Xinyuan-LilyGO/T-Echo-Lite/tools/win10 vscode platformio start/README.md

### Installing t-echo-lite board type for VSCode PlatformIO on Windows 10

* * *
1. Install [Python](https://www.python.org/downloads/).
    
2. Install
    
    Open cmd in the current directory and run the following program:
    
        python t-echo-lite_setup.py
