Xinyuan-LilyGO/T-Echo-Lite/firmware/[nRF52840_Module_V1.0][nrf52840_module]_firmware/README.md

# Firmware Modification Log

## 202607140916
### Changed firmware
- `[nRF52840_Module_V1.0][nrf52840_module]_firmware_202607140916`
### Change content
- 更新flash新型号兼容ZD25Q32D
