Xinyuan-LilyGO/T-Echo-Lite/image/10.png

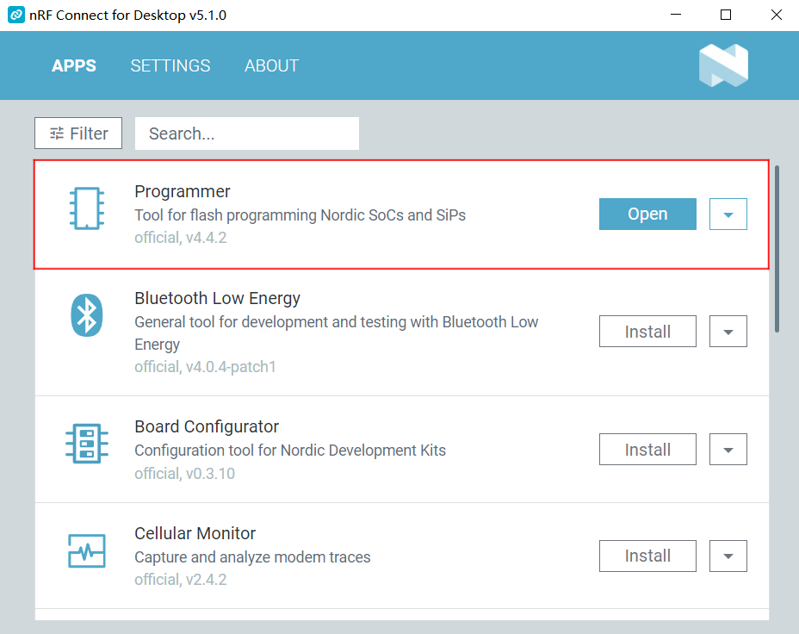
image/10.png
