Xinyuan-LilyGO/T-Echo-Lite/image/11.png

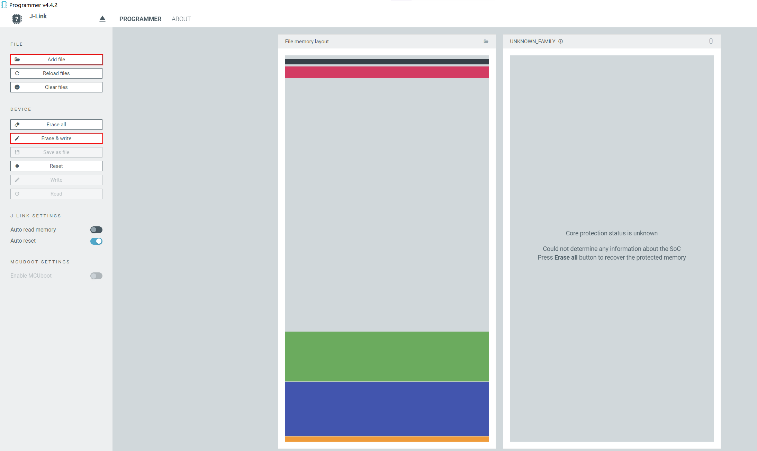
image/11.png
