Xinyuan-LilyGO/T-Echo-Lite/project/T-Echo-Lite_V1.0/3D_T-Echo-Lite-Eapper_Bot_202506101005.png

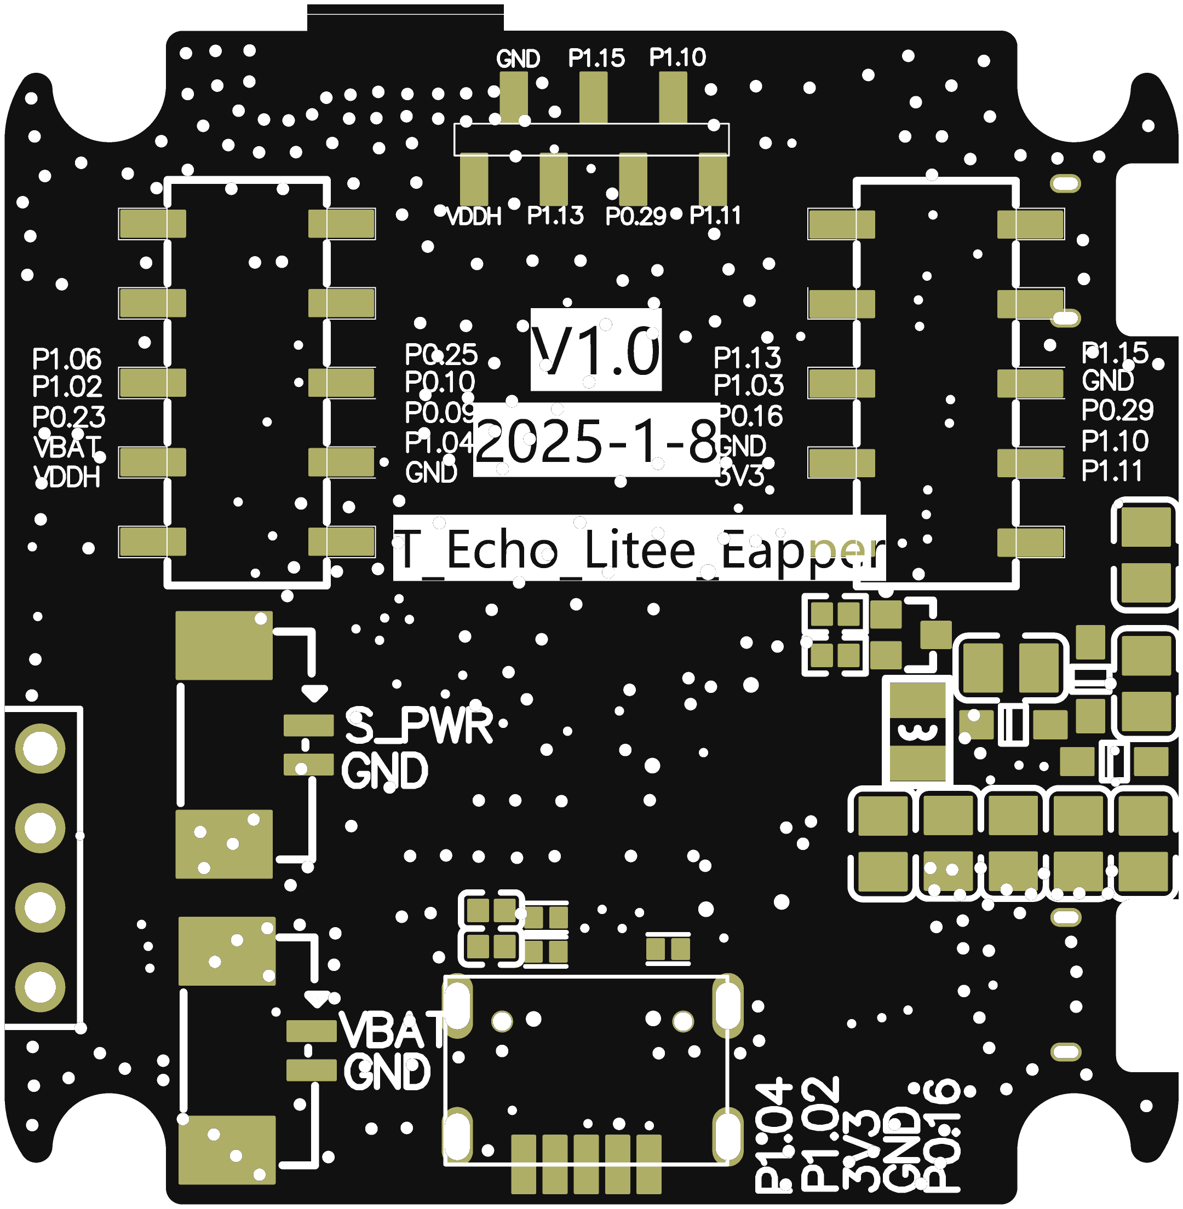
project/T-Echo-Lite_V1.0/3D_T-Echo-Lite-Eapper_Bot_202506101005.png
