Xinyuan-LilyGO/T-Echo-Lite/structure/总装.stl

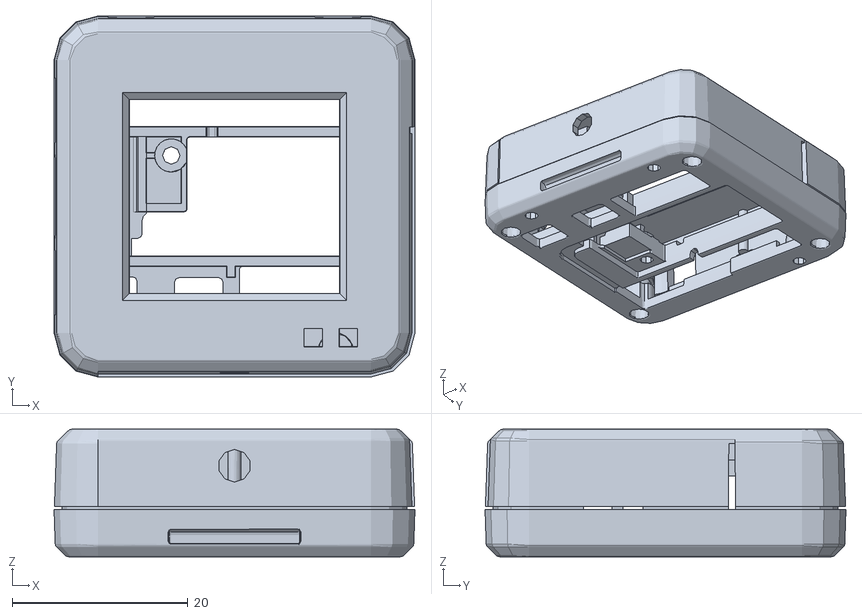
[picture p13: CAD file, 2025-06-09]
structure/总装.stl
41.0 x 41.0 x 14.5
