Xinyuan-LilyGO/T-Echo-Lite/structure/下壳.stl

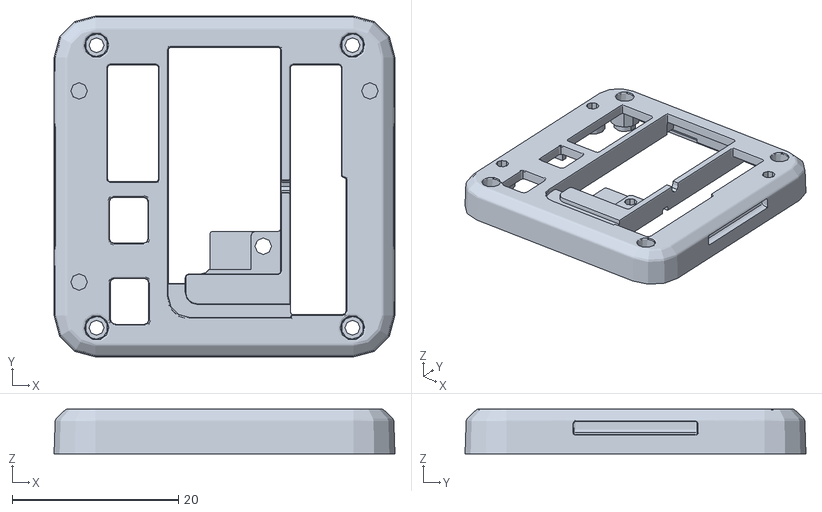
[picture p14: CAD file, 2025-06-09]
structure/下壳.stl
41.0 x 41.0 x 5.40
