Xinyuan-LilyGO/T-Echo-Lite/structure/上壳.stl

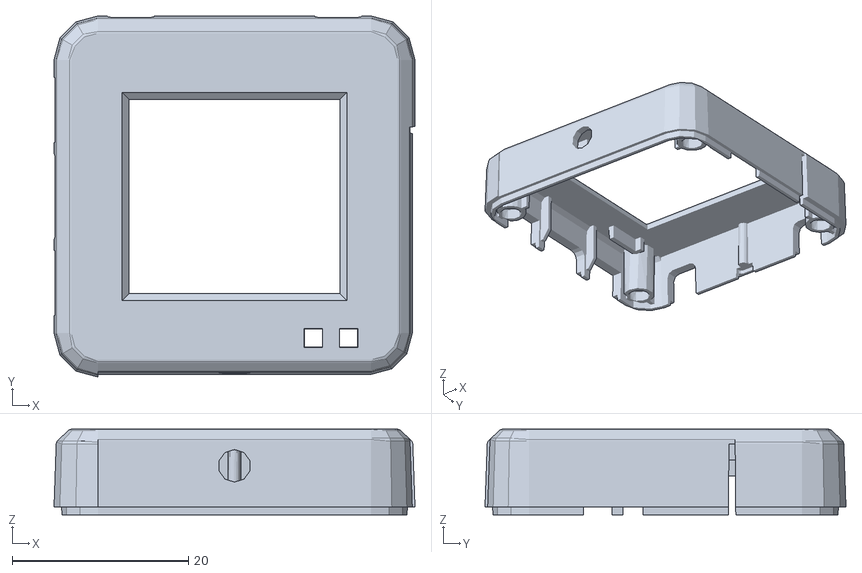
[picture p15: CAD file, 2025-06-09]
structure/上壳.stl
40.9 x 40.9 x 9.70
