Xinyuan-LilyGO/T-Echo-Lite/firmware/[T-Echo-Lite_V1.0][Original_Test]_firmware/README.md

# Firmware Modification Log

## 202607140937
### Changed firmware
- `[T-Echo-Lite_V1.0][Original_Test]_firmware_202607140937`
### Change content
- 将sx1262测试提到第一个测试，更新flash新型号兼容ZD25Q32D
