Xinyuan-LilyGO/T-Echo-Lite/firmware/[T-Echo-Lite-KeyShield_V1.0][original_test]_firmware/修改日志.md

## 202604090958
> #### [T-Echo-Lite-KeyShield_V1.0][original_test]_firmware_202604090958: 
>  * 添加自动进入浅睡眠

## 202512091700
> #### [T-Echo-Lite-KeyShield_V1.0][original_test]_firmware_202512091700: 
>  * 修复扬声器播放杂音问题

## 202511141051
> #### [T-Echo-Lite-KeyShield_V1.0][original_test]_firmware_202511141051: 
>  * 添加屏幕局部刷新功能，修复屏幕刷新卡顿问题

## 202510301608
> #### [T-Echo-Lite-KeyShield_V1.0][original_test]_firmware_202510301608: 
>  * 初始版本
