Xinyuan-LilyGO/T-Echo-Lite/(threads)

Thread 1 (2025-05-04):

Footprint for Core

lumo76, 2025-05-04:
### What features or library support or other would you like to add?

I would like to see a footprint of the core module which can be imported into kicad.

### Additional context.

_No response_

eabase, 2025-05-21:
➕1️⃣
Yes, a schematic would be much appreciated!
Especially since there are several ports and buttons not yet documented.

Llgok, 2025-05-22:
@eabase
Hello, we don't have a KiCad footprint library here. You can use specific tools to convert the footprints from our project library [T_Echo_lite.PcbLib](https://github.com/Xinyuan-LilyGO/T-Echo-Lite/blob/main/project/T-Echo-Lite_V1.0/T_Echo_lite.PcbLib) into a KiCad-compatible version.

eabase, 2025-05-22:
@Llgok
> You can use specific tools to convert

What tools? Convert from what exactly?

lumo76, 2025-05-22:
@Llgok
thanks, the .PcbLib file helps. Could you provide the symbol file for the core module as well, e.g. the .SchLib file?

lumo76, 2025-05-22:
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

kicad can import the footprint lib directly. E.g. https://forum.kicad.info/t/importing-altium-pcblib-files/39050

Llgok, 2025-05-24:
@lumo76
Updated [T_Echo_lite.SchLib](https://github.com/Xinyuan-LilyGO/T-Echo-Lite/blob/main/project/T-Echo-Lite_V1.0/T_Echo_lite.SchLib)

eabase, 2025-06-01:
@Llgok
Can you please alsoi provide the **`*.SchDoc`** file?

Llgok, 2025-06-04:
@eabase I am very sorry, but I am unable to provide you with the .SchDoc file and KiCad-related files. If you need to convert package library files and schematic library files, you can refer to the following open-source projects:[pcad2kicad](https://github.com/xtoolbox/pcad2kicad)

eabase, 2025-06-04:
@Llgok
You're not reading my post. **`*.SchDoc`** **is an Altium produced file**, and is needed in order import the schematics from anything else.

eabase, 2025-06-08:
Hi @Llgok
Unfortunately none of the files are rendering correctly.
The schematics only show 3 parts, and rendered outside the drawing boarders.

Can you can see and check for yourself by using the latest KiCad `9.0.2`.

Ultimately I would like to have the files for all the components in the `T-Echo-Lite` (with case and display).

---

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

Llgok, 2025-06-09:
Hello,@eabase
The exported file is fine. It contains the schematic and encapsulation of the T-Echo-Lite-Core_V1.0 module. If you are looking for the source project files for T-Echo-Lite (including the routed schematic (.SchDoc file), routed PCB (.PcbDoc file), and manufacturable Gerber files), I apologize that we cannot provide these source files at the moment due to confidentiality agreements. I will upload the shell files shortly.

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

Thread 2 (2025-05-21):

Documentation missing

eabase, 2025-05-21:
Hi,

I am missing all the documentation of the various ports, connectors and buttons.
1. Can you please upload the schematics and clearly document the side ports and 2 buttons?

2. How I can connect a GPS?

Also, you are referring to the **L67**` GPS module which is nowhere to be found.

3. **How/where can I get one, and how to connect in the meantime?**

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

Llgok, 2025-05-22:
@eabase
Hello, thank you very much for your feedback.

1.  You can access the schematic diagram of this project [Echo-Lite_V1.0](https://github.com/Xinyuan-LilyGO/T-Echo-Lite/blob/main/project/T-Echo-Lite_V1.0/T-Echo-Lite_V1.0.pdf), or directly visit the pin configuration interface [pinoverview](https://github.com/Xinyuan-LilyGO/T-Echo-Lite?tab=readme-ov-file#pinoverview) to obtain the corresponding IO numbers for MUC connections with other hardware devices.

2.  The connection method for GPS is designed according to the shell structure. You can confirm the GPS connection by referring to the reserved position for the GPS module in this diagram.
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

3.  You can purchase this GPS module [t-echo-lite](https://lilygo.cc/en-cn/products/t-echo-lite?variant=45350225215669) from our official store.

eabase, 2025-05-22:
Hi @Llgok,

The "pin overview" in the README is impossible to understand!

For example (to mention just a few):
- Why do you have **LED_1** pin connected to 3 different pins on the BT chip? Makes zero sense!
- What is the function(s) of the "Two SH1.0 external sockets pin"s?
- What is a "**Screen pin**"?

Llgok, 2025-05-24:
@eabase
Hello, I sincerely apologize for the inaccuracies in the README documentation that require corrections:

1.The three LEDs correspond to three distinct onboard LED pins (LED1, LED2, LED3). My earlier description was incorrect—two of these LED pins are already utilized by the bootloader.
2.The 'SH1.0 external socket pins' refer to the two port pins on the board, as shown in the diagram below.

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

3.The 'Screen pin' is the SPI pin for the e-ink display.

eabase, 2025-06-01:
Any update?

Llgok, 2025-06-04:
@eabase These are external expansion pins used to expand other devices.

Llgok, 2025-06-05:
@eabase Hello, here is the pinout diagram for the SH1.0 connector you requested.

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

eabase, 2025-06-08:
```
# "Con-1"
1.  GND
2.  VDD3V3 # +3.3 Volt
3.  P1-04
4.  P1-02

# "Con-2"
1.  GND
2.  VDD3V3 # +3.3 Volt
3.  P0-23
4.  P0-25
```

But I can't tell which connector is which from the picture above...

Llgok, 2025-06-09:
@eabase

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

eabase, 2025-06-10:
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

adrianTNT, 2025-06-11:
I also think the documentation and images / instructions can be improved, but I do appreciate that new devices are constantly added, it seems like LILYGO is a small team and things are not perfect, we need to figure many things on-the-fly.

eabase, 2025-06-16:
Sure, but the guys designing this also need to significantly improve their documentation to prevent all these repeated, dumb questions and replies. Just use an AI to make a checklist of all the items to provide in the documentation. It would also significantly reduce the extra work for the people maintaining these repos and answering basic questions.

Thread 3 (2025-05-21):

How to connect an external antenna?

eabase, 2025-05-21:
The boxed version doesn't expose the antenna connector.

**How can I attach an external antenna?**

Llgok, 2025-05-22:
@eabase
Hello, the boxed version comes with the onboard flexible PCB antenna by default. If you wish to use an external antenna, you will need to remove the casing. You can follow our official channels, as we will soon release a version with an external antenna casing.

eabase, 2025-05-22:
> You can follow our official channels, as we will soon release a version with an external antenna casing.

I just got this because I was following you "official channels" and it showed an antenna connector, so I obvious thought there would be one also on the box. I need an external antenna so should I send this unit back to you and you can replace it when you have one with the correct box? (Or better, just send me a new box when you get it?)

Llgok, 2025-05-24:
@eabase
You can contact the customer service of the mall where you purchased the product to request an exchange for the external antenna version.

eabase, 2025-06-01:
@Llgok
Thnaks for the info, but it's just too much hassle at this time. I'll keep it and can hopefully put it to use once you guys updated the docs and added the Meshtastic functionality.

Llgok, 2025-06-04:
@adrianTNT

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

Llgok, 2025-06-04:
@adrianTNT Okay, I will inform the relevant personnel to add antenna illustrations.

eabase, 2025-06-04:
I just opened the box, and connector is a the same location as above in non-shell version. However, the Internal side antenna is connected to the internal LoRa Ant connector (`U.FL-R-SMT`), and the BT one is unconnected. Is there another *chip* style BT antenna inside?

Llgok, 2025-06-05:
@eabase The Bluetooth antenna uses an onboard ceramic patch antenna

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

adrianTNT, 2025-06-06:
If the bluetooth uses the ceramic one in above image, then the Bluetooth small ipex connector is not linked on the circuits?
Or do they both work at once?
Thank you.

Llgok, 2025-06-06:
@adrianTNT Both work at the same time.

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

eabase, 2025-06-08:
@Llgok

> Both work at the same time.

I understand.  However, **this is incorrect antenna design** and simply destroy the antenna tuning and sensitivity. You can never connect 2 different antenna's inputs to the same signal line, without a switching network.

@adrianTNT

So if anyone intend to use the `UF.L` ipex connector, you'd first need to *either*:
 (a) completely de-solder the ceramic patch antenna, **or**
 (b) cut the line of ceramic patch antenna, on the PCB.

I suggest desoldering (a), as it doesn't damage the board in case you want to add it back in the future.

adrianTNT, 2025-06-09:
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

I needed something similar on the LILYGO T3 S3, for the Lo-Ra antenna and I found them too small to mess with these antenna pads and move resistor. This is Bluetooth, less important, but I had to clarify which antenna is which.

Would in theory work to make this antenna switch with a small jumper (like the old HDD jumper) or would this also mess with antenna sensitivity? If that works, it would be nice to have that from factory :D

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

Llgok, 2025-06-09:
@eabase
The end where the ceramic antenna and the external ipex work simultaneously belongs to the Bluetooth of the nRF52840, not the LoRa antenna. Normally, the Bluetooth antenna does not need to be frequently replaced. If you want to use your own Bluetooth antenna, you must use a soldering iron to remove the ceramic antenna to use the external ipex Bluetooth antenna. Even if a 0-ohm resistor is used to switch, a soldering iron is still required. The T-Echo-Lite is configured by default to use the onboard ceramic Bluetooth antenna.

Llgok, 2025-06-09:
@adrianTNT
It is not recommended or advisable to use a jumper seat as an antenna switch. Jumper seats are primarily used for temporary connections and debugging. If used as an antenna switch, the right-angle bend will cause significant antenna loss. Jumper seats can only be used as enable switches for chips or for testing purposes.

eabase, 2025-06-09:
@adrianTNT
I'm not convinced you have the skills or right equipment/tools to solder SMT parts on this scale. So I don't think adding a switching circuit **on** this board is a good option for you, especially since I see no space available to add any additional components. Make a choice or get a second device.

As LLgok said, any internal wires of the switch itself would act as an antenna, and also change the *reactance* ($X_c$) that need to be kept ~50 Ω to prevent signal loss.

adrianTNT, 2025-06-10:
> I'm not convinced you have the skills or right equipment/tools to solder SMT parts on this scale

I'm not convinced I would be able to do that eider :)

Thread 4 (2025-05-21):

Is this device Meshtastic compatible?

eabase, 2025-05-21:
Is this device compatible with Meshtastic?

If yes, how do I flash the correct Meshtastic FW?

Llgok, 2025-05-22:
@eabase
Hello, Meshtastic is currently not supported, but it will be adapted in the future.

eabase, 2025-05-22:
@Llgok
Then tell me what I should do with LoRa functionality if Meshtastic is not available?
(Or are you proposing I build my own LoRa ecosystem from scratch?)

This make no sense at all.

lumo76, 2025-05-22:
> [@eabase](https://github.com/eabase) Hello, Meshtastic is currently not supported, but it will be adapted in the future.

I hope this comes soon, especially as the T-Echo lite is advertised as "it can be used as a Lora node adapted to Meshtastic firmware."

In the interim, how big is the difference to the T-Echo, could the T-Echo firmware be adapted easily?

eabase, 2025-06-09:
@Llgok

> The adaptation of Meshtastic requires extensive testing..

Cool, I'm happy to help with testing if you like.

Szetya, 2025-06-16:
GPS is also working.
https://github.com/meshtastic/firmware/issues/6956#issuecomment-2977067540

Szetya, 2025-06-23:
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

Meshtastic is a multi-platform project with a shared codebase. The source code is not written for a specific device only — instead, there are common files and modules that are used across various hardware platforms (like ESP32, nRF52, etc.).

Each supported hardware platform has its own board-specific environment and configuration files (e.g., in the platformio.ini and hw directories), but the core logic is shared. This allows developers to build firmware for different devices while reusing most of the same source code.

What I’ve done is create a variant for a specific device or use-case, based on the shared codebase. However, since I haven’t submitted a pull request (PR) for it, my changes are not in the official Meshtastic GitHub repository.

The fact that my variant is not in the main repo doesn’t mean the code is unofficial or incompatible — it simply means it’s a separate build using the public, open-source code.

You can review the main repository yourself — the structure makes it clear that Meshtastic is designed to be adaptable to multiple boards, and many community variants exist that haven’t been merged into the upstream project.

So to be clear: the code is public, open-source, and modular — I’ve just built a version for a different target device using the same base code.

adrianTNT, 2025-06-25:
> [@eabase]([eabase](https://github.com/eabase))
>
> [...] I am not happy flashing undocumented binary firmware from random persons on internet, who refuse to share readable and reproducible source code.

@Szetya "I am not with him" ⬆ 😅 (sorry @eabase 😅).

I would still use any code I can get, until hopefully I will see this device on the Meshtastic flasher website 🤞

// There aren't many available boards like the T-Echo Lite with solar connector on them. The RackWireless ones cost more to ship here than the actual boards (for some reason).

Thread 6 (2025-06-13):

Connecting the battery to other pins

adrianTNT, 2025-06-13:
I want to put the T-Echo Lite in a very flat case and cannot use the normal battery connector (pointing upper from the board).
Can someone tell me where else I could connect the battery?
I found some pins that seem to work (highlighted in 2 of the below images), but I am unsure.
The `VBAT` and `GND` highighted on the larger connector are OK? Battery can still be charged by USB, no?

Thank you.

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

adrianTNT, 2025-06-13:
The markings  on the board really say "_Litee Eapper_" ? 😲😅

Llgok, 2025-06-17:
@adrianTNT
Hello, the VBAT pin on the 2x5P connector and the VBAT pin on the 2-pin battery connector are interconnected.

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

adrianTNT, 2025-06-18:
Thank you for the diagram.
Like you said, I ended up using that `VBAT` pin on the 2x5P pins. And for ground, the `GND` pin from the other group of 2x5P pins.
Worked OK.
