Xinyuan-LilyGO/T-Echo-Lite/project/T-Echo-Lite_V1.0/T-Echo-Lite_V1.0.pdf

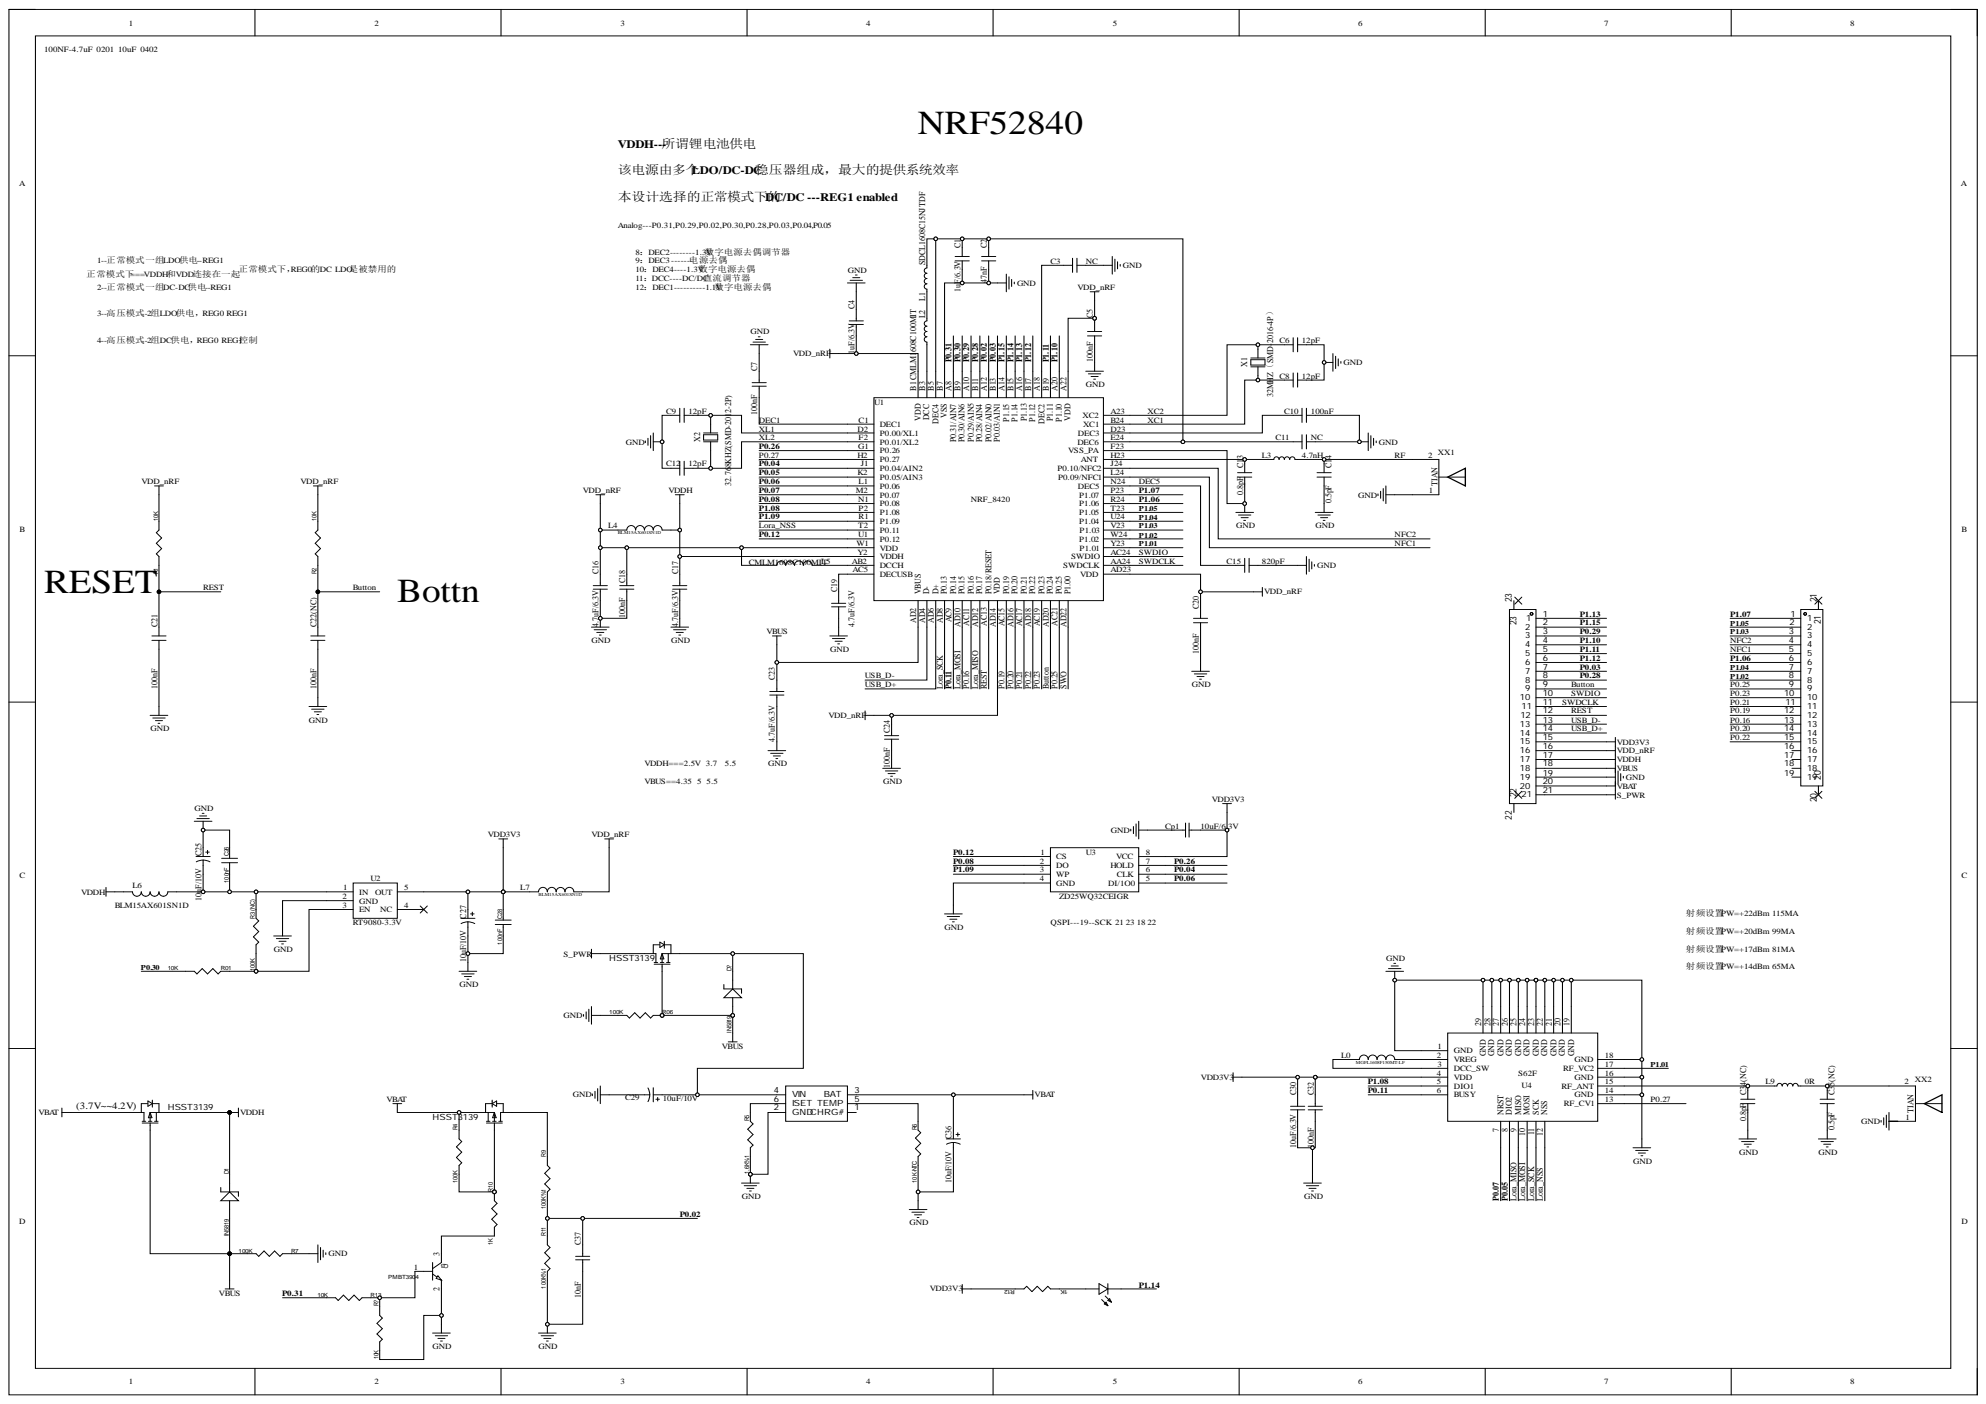
[picture p26: page 1]

该电源由多个LDO/DC-DC稳压器组成，最大的提供系统效率

1--正常模式一组LDO供电--REG1
正常模式下，REG0的DC LDO是被禁用的 正常模式下===VDDH和VDD连接在一起

P0.26 | VDD P0.26 G1 NRF_8420 | AD23 SWDCLK AA24 SWDIO AC24 P1.01 Y23 P1.02 W24 P1.03 V23 P1.04 U24 P1.05 T23 P1.06 R24 P1.07 P23 DEC5 N24 P0.09/NFC1 L24 P0.10/NFC2 J24 ANT H23 VSS_PA F23 DEC6 E24 DEC3 D23 XC1 B24 XC2 A23 VDD A22 P1.10 A20 P1.11 B19 DEC2 A18 P1.12 B17 P1.13 A16 P1.14 B15 P1.15 A14 P0.03/AIN1 B13 P0.02/AIN0 A12 P0.28/AIN4 B11 P0.29/AIN5 A10 P0.30/AIN6 B9 P0.31/AIN7 A8 VSS B7 DEC4 B5 DCC B3 VDD B1

VDD W1 | P1.01 | NFC1
VDDH Y2 | SWDIO
DCCH AB2 DECUSB AC5 | SWDCLK

18 ND 19 GND 20 GND 21 GND 22 GND 23 GND 24 GND 25 GND 26 GND 27 GND 28 GND 29

DCC_SW 3 RF_CV1 | 13 GND 14 RF_ANT 15 GND 16 RF_VC2 17 GND

P1.08 | DIO1 5
