Xinyuan-LilyGO/T-Echo-Lite/project/T-Echo-Lite-KeyShield_V1.0/T-Echo-Lite-KeyShield_1_V1.0.pdf

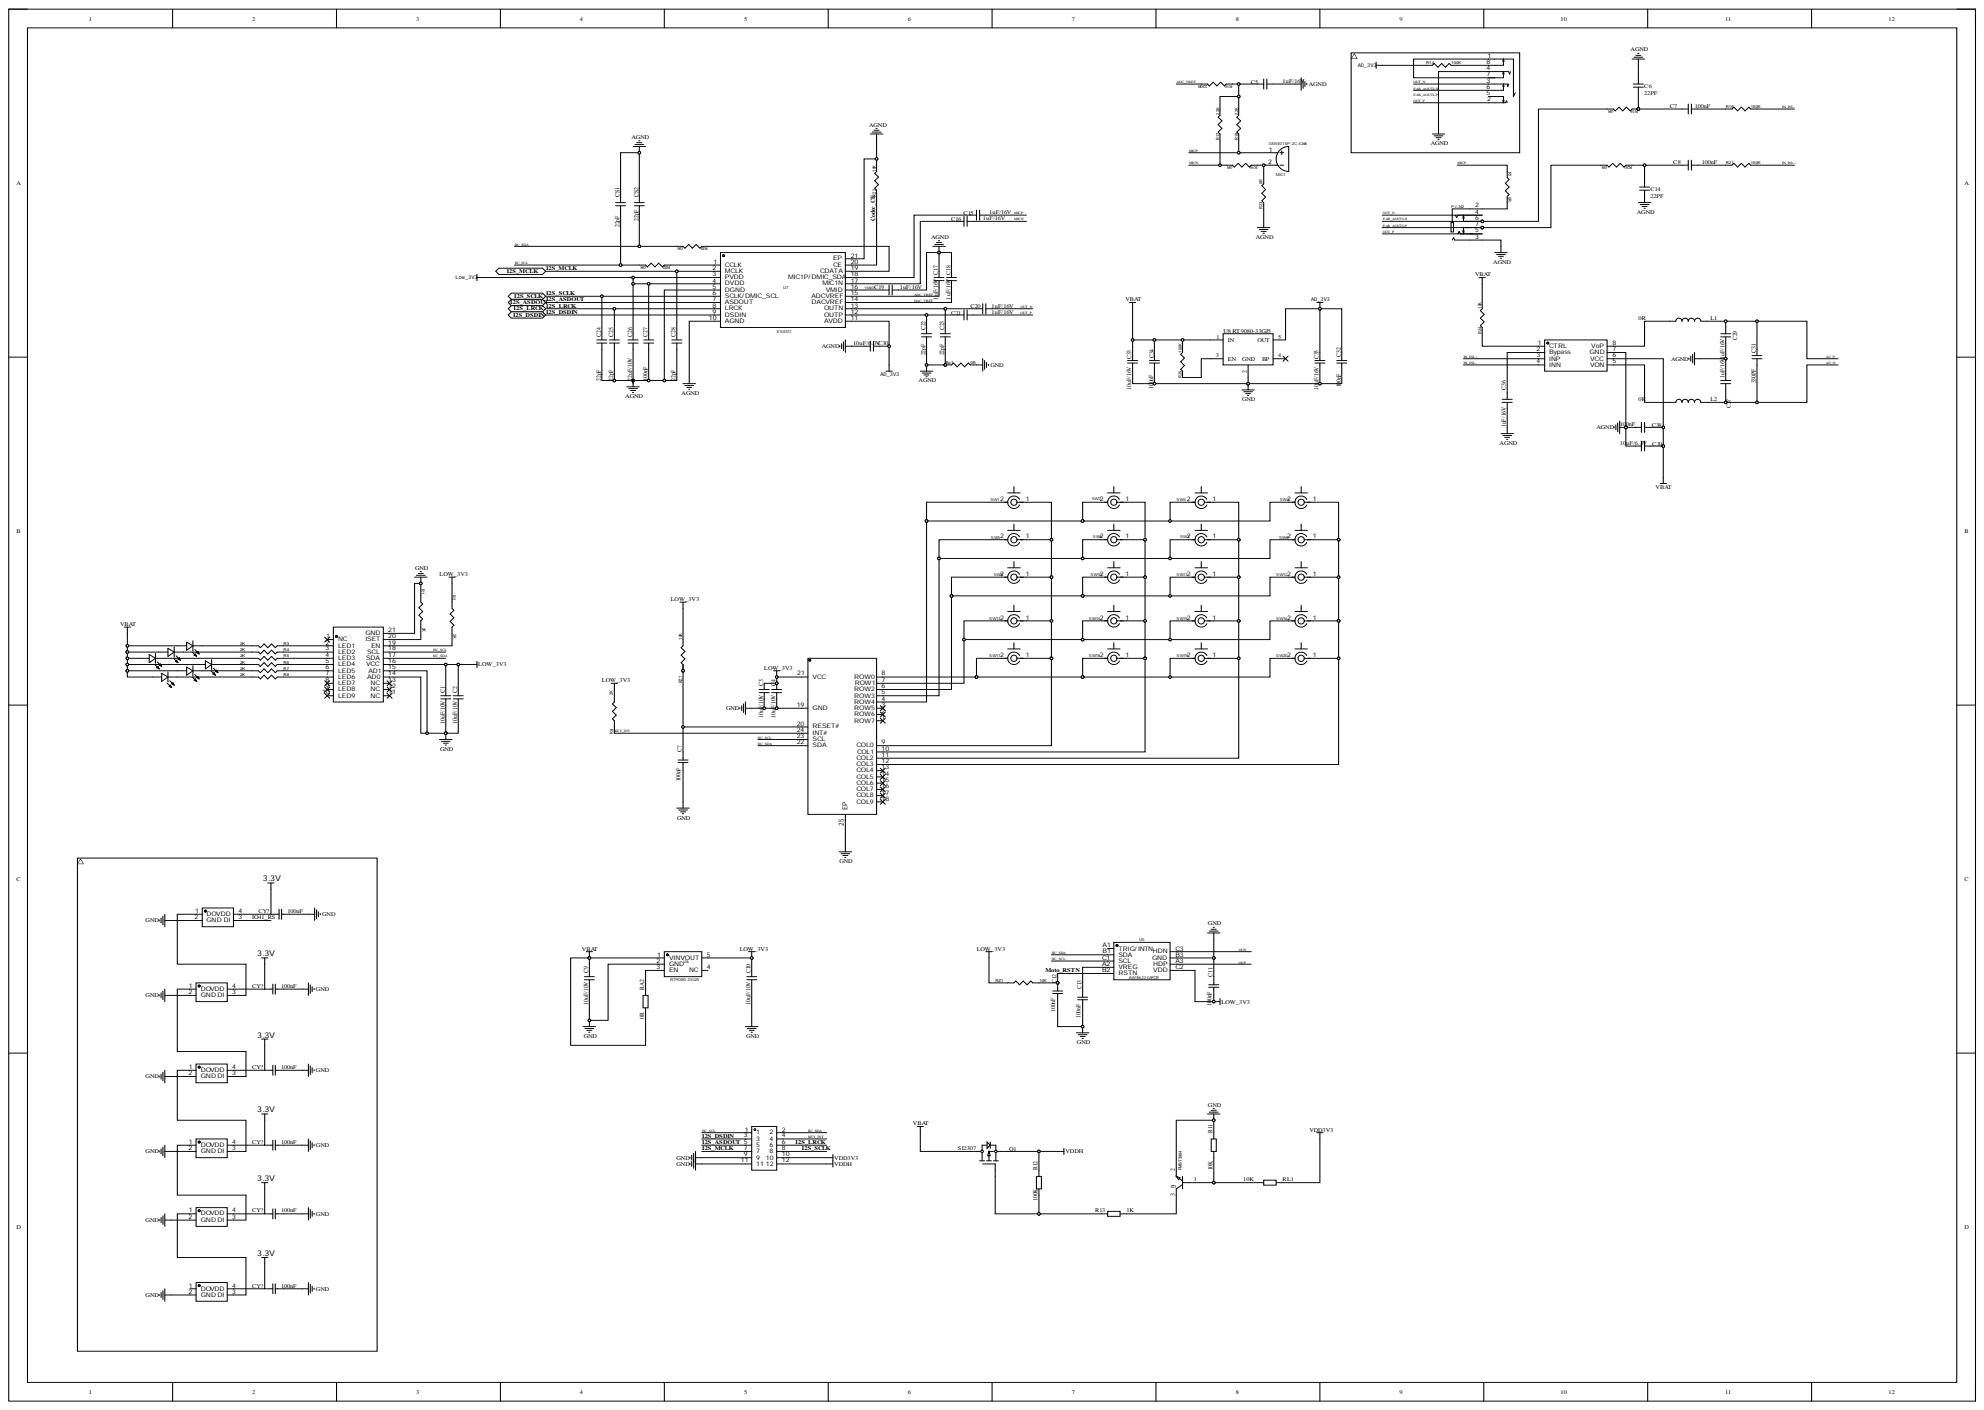
[picture p27: page 1]

VMIDC19 | 1uF/16V ADC_VREF

C21 | 1uF/16V OUT_P
