Xinyuan-LilyGO/T-Echo-Lite/project/T-Echo-Lite-KeyShield_V1.0/T-Echo-Lite-KeyShield_2_V1.0.pdf

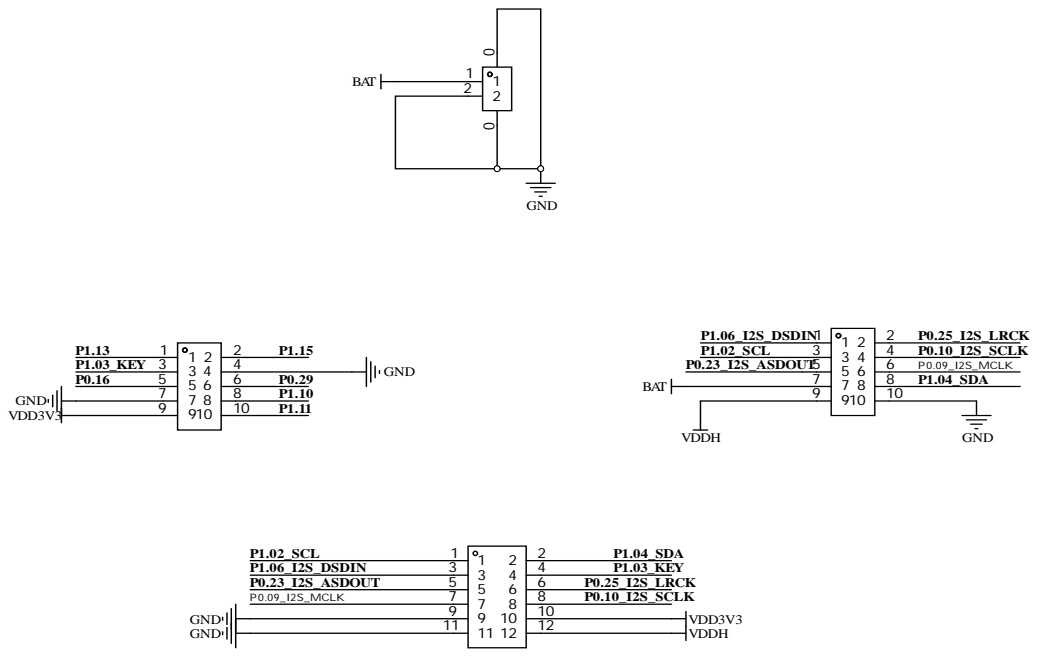
[picture p28: page 1]
