Xinyuan-LilyGO/T-Echo-Lite/project/T-Echo-Lite_V1.0/T-Echo-Lite-Eapper_V1.0.pdf

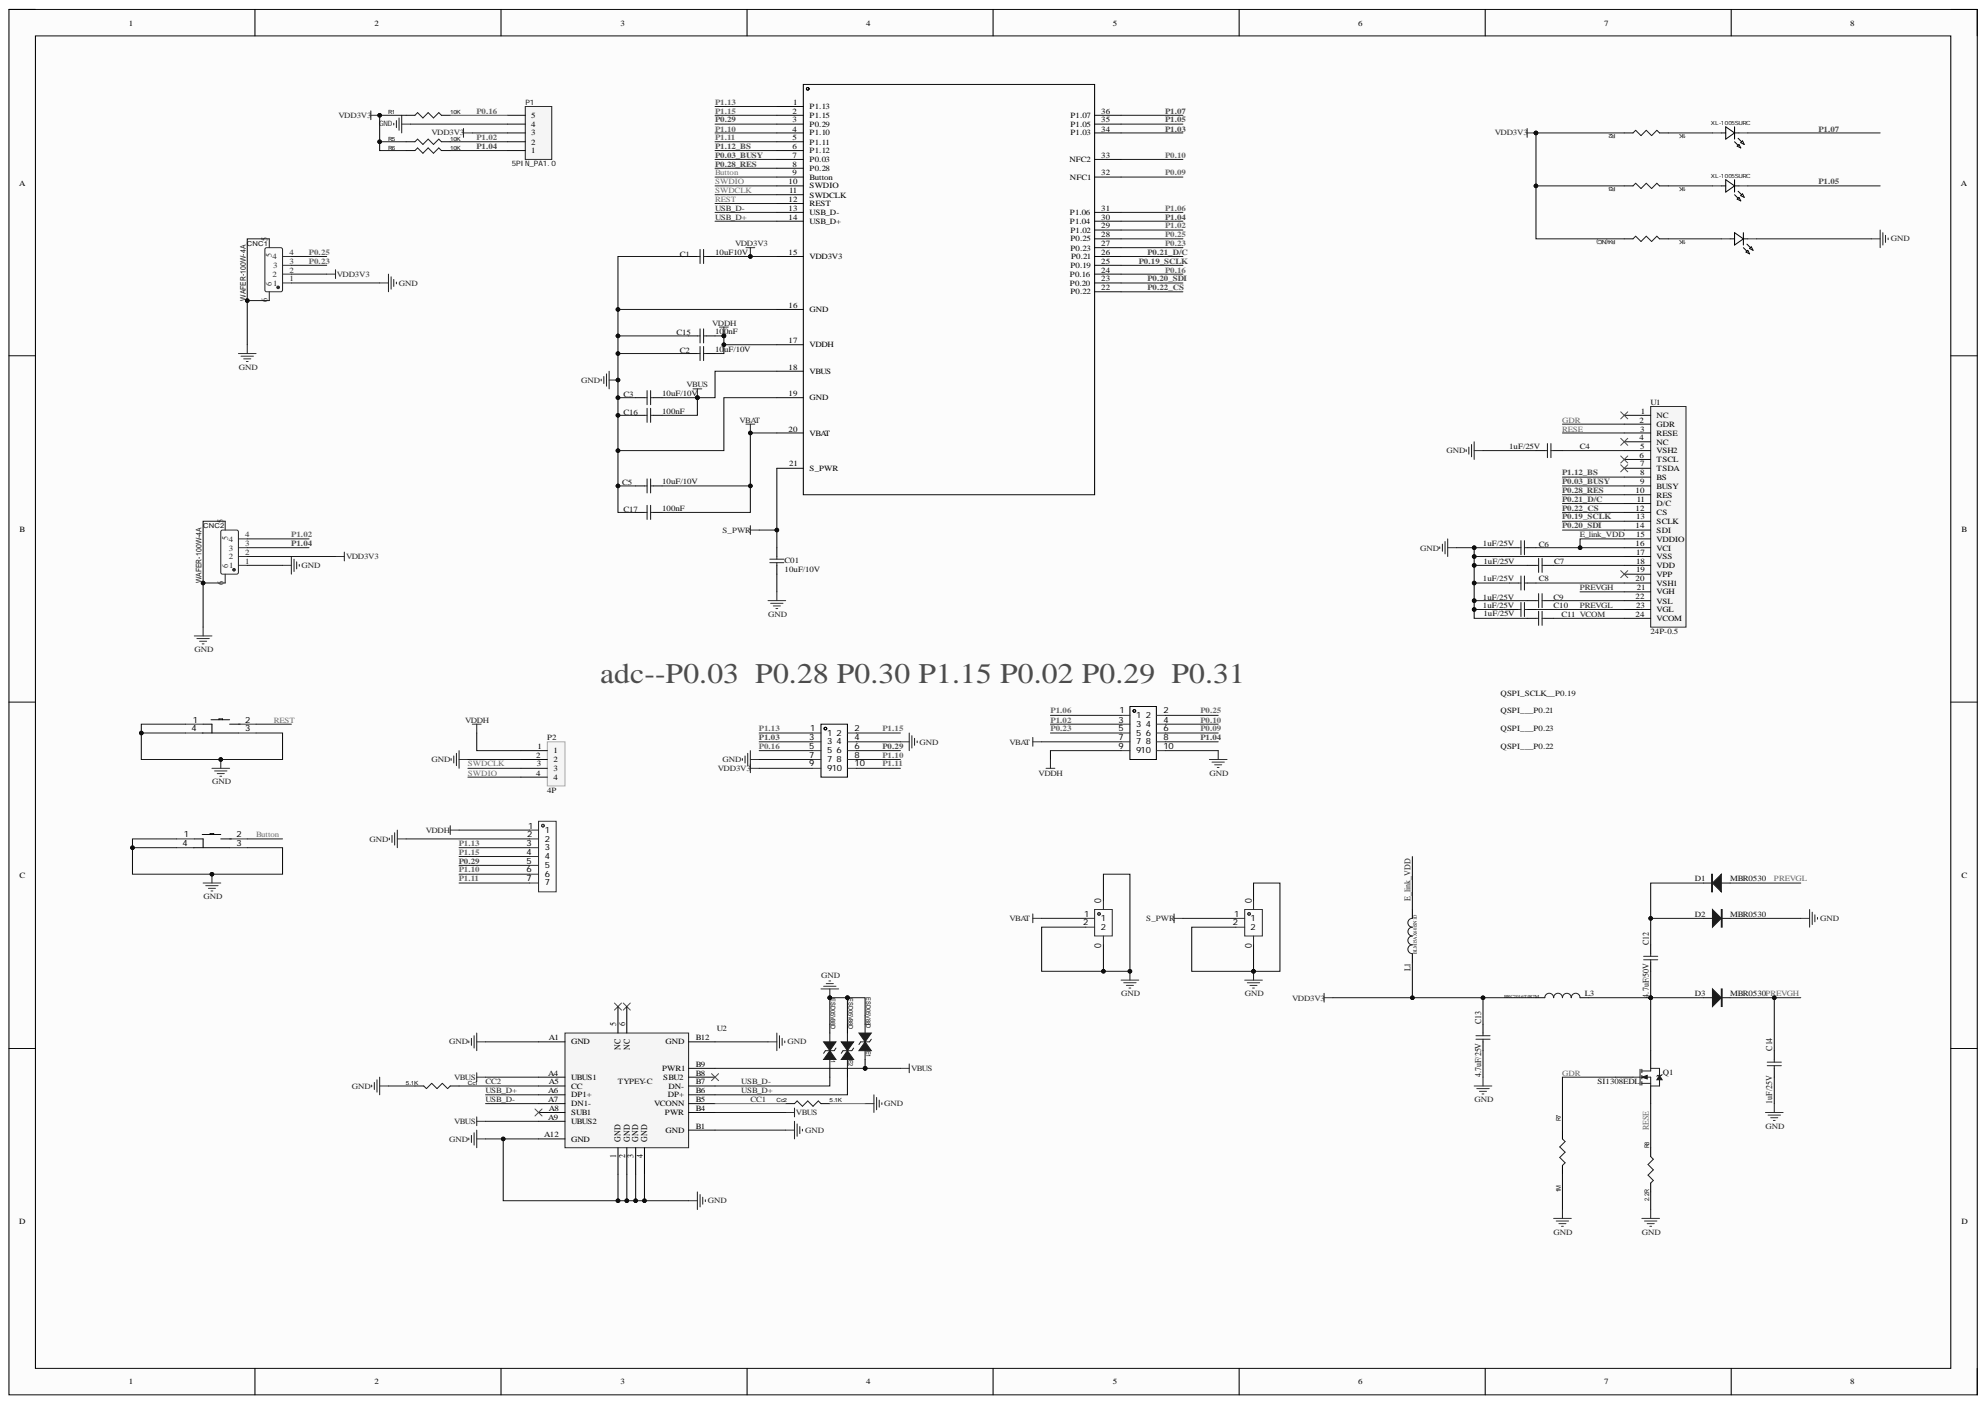
[picture p29: page 1]
