Xinyuan-LilyGO/T-Echo-Lite/(list of files, drawings)

Other design files:
project/T-Echo-Lite_V1.0/T-Echo-Lite-Core_V1.0/lceda eda/T-Echo-Lite-Core_V1.0.eprj
