Xinyuan-LilyGO/T-Echo-Lite/project/T-Echo-Lite_V1.0/T-Echo-Lite-Core_V1.0/kicad/T-Echo-Lite-Core_V1.0.kicad_pcb

## KiCad design project/T-Echo-Lite_V1.0/T-Echo-Lite-Core_V1.0/kicad/T-Echo-Lite-Core_V1.0.kicad_pcb (2025-06-05)

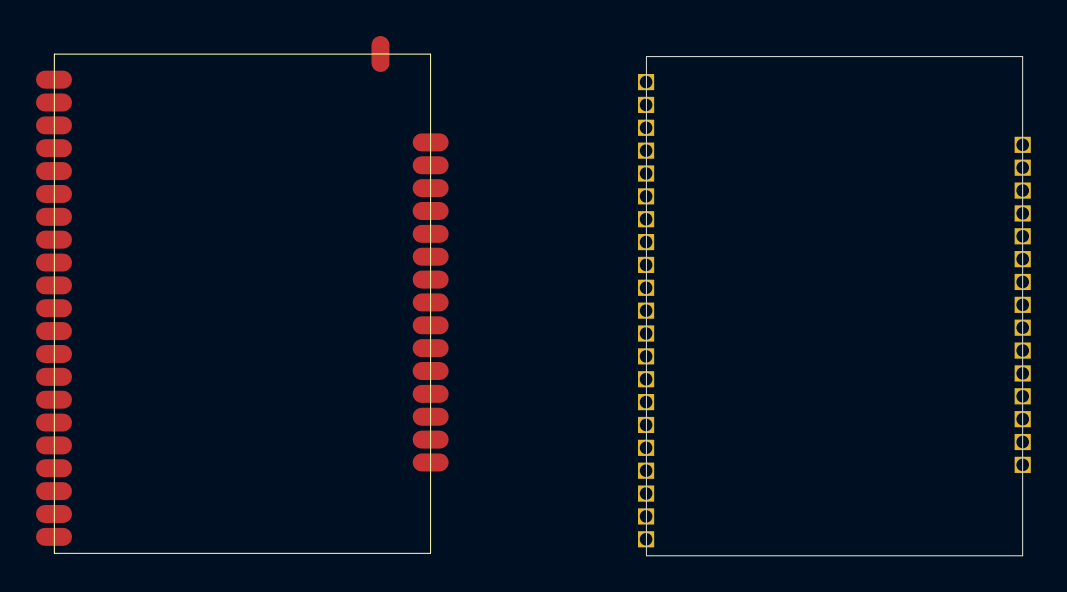
[picture p30: board T-Echo-Lite-Core_V1.0.kicad_pcb from above]

Board: 2 copper layers, 20.9 x 27.7 mm, 3 parts (0 on the bottom side), 26 nets, no tracks yet.

Parts:
P0: SPAD___21
P3: SPAD___15
U?: T_Ech0_lite

Connections:
BUTTON: P0.9, U?.9
GND: P0.19, U?.19
P0.16: P3.13, U?.24
P0.23: P3.10, U?.27
P0.25: P3.9, U?.28
P0.29: P0.3, U?.3
P1.02: P3.8, U?.29
P1.03: P3.3, U?.34
P1.04: P3.7, U?.30
P1.05: P3.2, U?.35
P1.06: P3.6, U?.31
P1.07: P3.1, U?.36
P1.10: P0.4, U?.4
P1.11: P0.5, U?.5
P1.15: P0.2, U?.2
REST: P0.12, U?.12
SWDCLK: P0.11, U?.11
SWDIO: P0.10, U?.10
S_PWR: P0.21, U?.21
USB_D+: P0.14, U?.14
USB_D-: P0.13, U?.13
VBAT: P0.20, U?.20
VBUS: P0.18, U?.18
VDD3V3: P0.15, U?.15
VDDH: P0.17, U?.17
VDD_NRF: P0.16, U?.16
