Xinyuan-LilyGO/T-Echo-Lite/examples/T-Echo-Lite-KeyShield/general_test/lvgl_font_google_sans_flex_regular_13.c

/*******************************************************************************
 * Size: 13 px
 * Bpp: 1
 * Opts: --font assets\font\google_sans_flex\GoogleSansFlex_24pt-Regular.ttf -r 0x20-0x7E --size 13 --bpp 1 --format lvgl --lv-include lvgl.h --lv-font-name lvgl_font_google_sans_flex_regular_13 --no-compress -o examples\T-Echo-Lite-KeyShield\general_test\lvgl_font_google_sans_flex_regular_13.c
 ******************************************************************************/

#ifdef LV_LVGL_H_INCLUDE_SIMPLE
#include "lvgl.h"
#else
#include "lvgl.h"
#endif

#ifndef LVGL_FONT_GOOGLE_SANS_FLEX_REGULAR_13
#define LVGL_FONT_GOOGLE_SANS_FLEX_REGULAR_13 1
#endif

#if LVGL_FONT_GOOGLE_SANS_FLEX_REGULAR_13

/*-----------------
 *    BITMAPS
 *----------------*/

/*Store the image of the glyphs*/
static LV_ATTRIBUTE_LARGE_CONST const uint8_t glyph_bitmap[] = {
    /* U+0020 " " */
    0x0,

    /* U+0021 "!" */
    0xfe, 0x40,

    /* U+0022 "\"" */
    0xb6, 0x80,

    /* U+0023 "#" */
    0x12, 0x12, 0x14, 0x7f, 0x24, 0x24, 0xfe, 0x24,
    0x24, 0x28,

    /* U+0024 "$" */
    0x21, 0xea, 0xe8, 0xe1, 0xc3, 0x89, 0xa7, 0xb7,
    0x88,

    /* U+0025 "%" */
    0x60, 0xa4, 0x49, 0x22, 0x58, 0x64, 0x2, 0x61,
    0xa4, 0x49, 0x22, 0x50, 0x60,

    /* U+0026 "&" */
    0x30, 0x91, 0x3, 0x6, 0x12, 0x22, 0xc7, 0xc4,
    0xf4,

    /* U+0027 "'" */
    0xe0,

    /* U+0028 "(" */
    0xd, 0x29, 0x24, 0x99, 0x32,

    /* U+0029 ")" */
    0x11, 0x22, 0x49, 0x2d, 0x68,

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

    /* U+0066 "f" */
    0x34, 0x4f, 0x44, 0x44, 0x44,

    /* U+0067 "g" */
    0x77, 0x38, 0x61, 0x87, 0x37, 0x41, 0xcd, 0xe0,

    /* U+0068 "h" */
    0x82, 0x8, 0x2e, 0xc6, 0x18, 0x61, 0x86, 0x10,

    /* U+0069 "i" */
    0x9f, 0xc0,

    /* U+006A "j" */
    0x20, 0x12, 0x49, 0x24, 0x9c,

    /* U+006B "k" */
    0x82, 0x8, 0x22, 0x92, 0x8e, 0x24, 0x9a, 0x20,

    /* U+006C "l" */
    0xff, 0xc0,

    /* U+006D "m" */
    0xf7, 0x66, 0x62, 0x31, 0x18, 0x8c, 0x46, 0x22,

    /* U+006E "n" */
    0xbb, 0x18, 0x61, 0x86, 0x18, 0x40,

    /* U+006F "o" */
    0x38, 0x8a, 0xc, 0x18, 0x28, 0x8e, 0x0,

    /* U+0070 "p" */
    0xbb, 0x38, 0x61, 0x87, 0x3b, 0xa0, 0x82, 0x0,

    /* U+0071 "q" */
    0x77, 0x38, 0x61, 0x87, 0x37, 0x41, 0x4, 0x10,

    /* U+0072 "r" */
    0xbd, 0x88, 0x88, 0x80,

    /* U+0073 "s" */
    0x74, 0x60, 0xe0, 0xc5, 0xc0,

    /* U+0074 "t" */
    0x44, 0xf4, 0x44, 0x44, 0x70,

    /* U+0075 "u" */
    0x86, 0x18, 0x61, 0x86, 0x37, 0x40,

    /* U+0076 "v" */
    0x84, 0x89, 0x33, 0x42, 0x86, 0x4, 0x0,

    /* U+0077 "w" */
    0x8c, 0x53, 0x34, 0xc9, 0x4a, 0x52, 0x8c, 0xc3,
    0x10,

    /* U+0078 "x" */
    0xc5, 0x23, 0x8c, 0x39, 0x2c, 0x40,

    /* U+0079 "y" */
    0x84, 0x89, 0x31, 0x42, 0x86, 0x4, 0x18, 0x20,
    0x40,

    /* U+007A "z" */
    0xf8, 0xcc, 0x44, 0x63, 0xe0,

    /* U+007B "{" */
    0x29, 0x25, 0x12, 0x49, 0x10,

    /* U+007C "|" */
    0xff, 0xfc,

    /* U+007D "}" */
    0x89, 0x24, 0x52, 0x49, 0x40,

    /* U+007E "~" */
    0x66, 0x70
};


/*---------------------
 *  GLYPH DESCRIPTION
 *--------------------*/

static const lv_font_fmt_txt_glyph_dsc_t glyph_dsc[] = {
    {.bitmap_index = 0, .adv_w = 0, .box_w = 0, .box_h = 0, .ofs_x = 0, .ofs_y = 0} /* id = 0 reserved */,
    {.bitmap_index = 0, .adv_w = 46, .box_w = 1, .box_h = 1, .ofs_x = 0, .ofs_y = 0},
    {.bitmap_index = 1, .adv_w = 67, .box_w = 1, .box_h = 10, .ofs_x = 1, .ofs_y = 0},
    {.bitmap_index = 3, .adv_w = 67, .box_w = 3, .box_h = 3, .ofs_x = 1, .ofs_y = 7},
    {.bitmap_index = 5, .adv_w = 133, .box_w = 8, .box_h = 10, .ofs_x = 0, .ofs_y = 0},
    {.bitmap_index = 15, .adv_w = 125, .box_w = 6, .box_h = 12, .ofs_x = 1, .ofs_y = -1},
    {.bitmap_index = 24, .adv_w = 173, .box_w = 10, .box_h = 10, .ofs_x = 1, .ofs_y = 0},
    {.bitmap_index = 37, .adv_w = 130, .box_w = 7, .box_h = 10, .ofs_x = 1, .ofs_y = 0},
    {.bitmap_index = 46, .adv_w = 37, .box_w = 1, .box_h = 3, .ofs_x = 1, .ofs_y = 7},
    {.bitmap_index = 47, .adv_w = 68, .box_w = 3, .box_h = 13, .ofs_x = 1, .ofs_y = -2},
    {.bitmap_index = 52, .adv_w = 68, .box_w = 3, .box_h = 13, .ofs_x = 0, .ofs_y = -2},
    {.bitmap_index = 57, .adv_w = 89, .box_w = 5, .box_h = 5, .ofs_x = 0, .ofs_y = 5},
    {.bitmap_index = 61, .adv_w = 116, .box_w = 5, .box_h = 6, .ofs_x = 1, .ofs_y = 1},
    {.bitmap_index = 65, .adv_w = 49, .box_w = 2, .box_h = 3, .ofs_x = 1, .ofs_y = -1},
    {.bitmap_index = 66, .adv_w = 70, .box_w = 4, .box_h = 1, .ofs_x = 0, .ofs_y = 4},
    {.bitmap_index = 67, .adv_w = 49, .box_w = 1, .box_h = 1, .ofs_x = 1, .ofs_y = 0},
    {.bitmap_index = 68, .adv_w = 63, .box_w = 4, .box_h = 10, .ofs_x = 0, .ofs_y = 0},
    {.bitmap_index = 73, .adv_w = 134, .box_w = 7, .box_h = 10, .ofs_x = 1, .ofs_y = 0},
    {.bitmap_index = 82, .adv_w = 76, .box_w = 3, .box_h = 10, .ofs_x = 1, .ofs_y = 0},
    {.bitmap_index = 86, .adv_w = 109, .box_w = 5, .box_h = 10, .ofs_x = 1, .ofs_y = 0},
    {.bitmap_index = 93, .adv_w = 111, .box_w = 6, .box_h = 10, .ofs_x = 0, .ofs_y = 0},
    {.bitmap_index = 101, .adv_w = 123, .box_w = 6, .box_h = 10, .ofs_x = 1, .ofs_y = 0},
    {.bitmap_index = 109, .adv_w = 117, .box_w = 6, .box_h = 10, .ofs_x = 1, .ofs_y = 0},
    {.bitmap_index = 117, .adv_w = 116, .box_w = 6, .box_h = 10, .ofs_x = 1, .ofs_y = 0},
    {.bitmap_index = 125, .adv_w = 103, .box_w = 6, .box_h = 10, .ofs_x = 1, .ofs_y = 0},
    {.bitmap_index = 133, .adv_w = 115, .box_w = 6, .box_h = 10, .ofs_x = 1, .ofs_y = 0},
    {.bitmap_index = 141, .adv_w = 116, .box_w = 6, .box_h = 10, .ofs_x = 1, .ofs_y = 0},
    {.bitmap_index = 149, .adv_w = 49, .box_w = 1, .box_h = 7, .ofs_x = 1, .ofs_y = 0},
    {.bitmap_index = 150, .adv_w = 49, .box_w = 1, .box_h = 8, .ofs_x = 1, .ofs_y = -1},
    {.bitmap_index = 151, .adv_w = 116, .box_w = 6, .box_h = 6, .ofs_x = 1, .ofs_y = 1},
    {.bitmap_index = 156, .adv_w = 116, .box_w = 6, .box_h = 4, .ofs_x = 1, .ofs_y = 2},
    {.bitmap_index = 159, .adv_w = 116, .box_w = 6, .box_h = 6, .ofs_x = 1, .ofs_y = 1},
    {.bitmap_index = 164, .adv_w = 99, .box_w = 5, .box_h = 10, .ofs_x = 0, .ofs_y = 0},
    {.bitmap_index = 171, .adv_w = 184, .box_w = 10, .box_h = 10, .ofs_x = 1, .ofs_y = -1},
    {.bitmap_index = 184, .adv_w = 139, .box_w = 9, .box_h = 10, .ofs_x = 0, .ofs_y = 0},
    {.bitmap_index = 196, .adv_w = 125, .box_w = 6, .box_h = 10, .ofs_x = 1, .ofs_y = 0},
    {.bitmap_index = 204, .adv_w = 153, .box_w = 8, .box_h = 10, .ofs_x = 1, .ofs_y = 0},
    {.bitmap_index = 214, .adv_w = 146, .box_w = 7, .box_h = 10, .ofs_x = 1, .ofs_y = 0},
    {.bitmap_index = 223, .adv_w = 114, .box_w = 5, .box_h = 10, .ofs_x = 1, .ofs_y = 0},
    {.bitmap_index = 230, .adv_w = 110, .box_w = 5, .box_h = 10, .ofs_x = 1, .ofs_y = 0},
    {.bitmap_index = 237, .adv_w = 164, .box_w = 10, .box_h = 10, .ofs_x = 1, .ofs_y = 0},
    {.bitmap_index = 250, .adv_w = 145, .box_w = 7, .box_h = 10, .ofs_x = 1, .ofs_y = 0},
    {.bitmap_index = 259, .adv_w = 50, .box_w = 1, .box_h = 10, .ofs_x = 1, .ofs_y = 0},
    {.bitmap_index = 261, .adv_w = 110, .box_w = 6, .box_h = 10, .ofs_x = 0, .ofs_y = 0},
    {.bitmap_index = 269, .adv_w = 130, .box_w = 7, .box_h = 10, .ofs_x = 1, .ofs_y = 0},
    {.bitmap_index = 278, .adv_w = 105, .box_w = 5, .box_h = 10, .ofs_x = 1, .ofs_y = 0},
    {.bitmap_index = 285, .adv_w = 180, .box_w = 9, .box_h = 10, .ofs_x = 1, .ofs_y = 0},
    {.bitmap_index = 297, .adv_w = 147, .box_w = 7, .box_h = 10, .ofs_x = 1, .ofs_y = 0},
    {.bitmap_index = 306, .adv_w = 171, .box_w = 9, .box_h = 10, .ofs_x = 1, .ofs_y = 0},
    {.bitmap_index = 318, .adv_w = 119, .box_w = 6, .box_h = 10, .ofs_x = 1, .ofs_y = 0},
    {.bitmap_index = 326, .adv_w = 171, .box_w = 9, .box_h = 11, .ofs_x = 1, .ofs_y = -1},
    {.bitmap_index = 339, .adv_w = 121, .box_w = 6, .box_h = 10, .ofs_x = 1, .ofs_y = 0},
    {.bitmap_index = 347, .adv_w = 114, .box_w = 6, .box_h = 10, .ofs_x = 1, .ofs_y = 0},
    {.bitmap_index = 355, .adv_w = 111, .box_w = 7, .box_h = 10, .ofs_x = 0, .ofs_y = 0},
    {.bitmap_index = 364, .adv_w = 136, .box_w = 7, .box_h = 10, .ofs_x = 1, .ofs_y = 0},
    {.bitmap_index = 373, .adv_w = 131, .box_w = 8, .box_h = 10, .ofs_x = 0, .ofs_y = 0},
    {.bitmap_index = 383, .adv_w = 196, .box_w = 12, .box_h = 10, .ofs_x = 0, .ofs_y = 0},
    {.bitmap_index = 398, .adv_w = 132, .box_w = 8, .box_h = 10, .ofs_x = 0, .ofs_y = 0},
    {.bitmap_index = 408, .adv_w = 124, .box_w = 7, .box_h = 10, .ofs_x = 0, .ofs_y = 0},
    {.bitmap_index = 417, .adv_w = 119, .box_w = 6, .box_h = 10, .ofs_x = 1, .ofs_y = 0},
    {.bitmap_index = 425, .adv_w = 79, .box_w = 3, .box_h = 12, .ofs_x = 1, .ofs_y = -2},
    {.bitmap_index = 430, .adv_w = 63, .box_w = 4, .box_h = 10, .ofs_x = 0, .ofs_y = 0},
    {.bitmap_index = 435, .adv_w = 79, .box_w = 3, .box_h = 12, .ofs_x = 1, .ofs_y = -2},
    {.bitmap_index = 440, .adv_w = 97, .box_w = 6, .box_h = 4, .ofs_x = 0, .ofs_y = 5},
    {.bitmap_index = 443, .adv_w = 116, .box_w = 6, .box_h = 1, .ofs_x = 1, .ofs_y = -2},
    {.bitmap_index = 444, .adv_w = 93, .box_w = 2, .box_h = 2, .ofs_x = 2, .ofs_y = 8},
    {.bitmap_index = 445, .adv_w = 111, .box_w = 6, .box_h = 7, .ofs_x = 1, .ofs_y = 0},
    {.bitmap_index = 451, .adv_w = 125, .box_w = 6, .box_h = 10, .ofs_x = 1, .ofs_y = 0},
    {.bitmap_index = 459, .adv_w = 113, .box_w = 6, .box_h = 7, .ofs_x = 1, .ofs_y = 0},
    {.bitmap_index = 465, .adv_w = 125, .box_w = 6, .box_h = 10, .ofs_x = 1, .ofs_y = 0},
    {.bitmap_index = 473, .adv_w = 117, .box_w = 7, .box_h = 7, .ofs_x = 1, .ofs_y = 0},
    {.bitmap_index = 480, .adv_w = 78, .box_w = 4, .box_h = 10, .ofs_x = 1, .ofs_y = 0},
    {.bitmap_index = 485, .adv_w = 124, .box_w = 6, .box_h = 10, .ofs_x = 1, .ofs_y = -3},
    {.bitmap_index = 493, .adv_w = 116, .box_w = 6, .box_h = 10, .ofs_x = 1, .ofs_y = 0},
    {.bitmap_index = 501, .adv_w = 47, .box_w = 1, .box_h = 10, .ofs_x = 1, .ofs_y = 0},
    {.bitmap_index = 503, .adv_w = 47, .box_w = 3, .box_h = 13, .ofs_x = -1, .ofs_y = -3},
    {.bitmap_index = 508, .adv_w = 105, .box_w = 6, .box_h = 10, .ofs_x = 1, .ofs_y = 0},
    {.bitmap_index = 516, .adv_w = 43, .box_w = 1, .box_h = 10, .ofs_x = 1, .ofs_y = 0},
    {.bitmap_index = 518, .adv_w = 182, .box_w = 9, .box_h = 7, .ofs_x = 1, .ofs_y = 0},
    {.bitmap_index = 526, .adv_w = 116, .box_w = 6, .box_h = 7, .ofs_x = 1, .ofs_y = 0},
    {.bitmap_index = 532, .adv_w = 124, .box_w = 7, .box_h = 7, .ofs_x = 1, .ofs_y = 0},
    {.bitmap_index = 539, .adv_w = 125, .box_w = 6, .box_h = 10, .ofs_x = 1, .ofs_y = -3},
    {.bitmap_index = 547, .adv_w = 125, .box_w = 6, .box_h = 10, .ofs_x = 1, .ofs_y = -3},
    {.bitmap_index = 555, .adv_w = 77, .box_w = 4, .box_h = 7, .ofs_x = 1, .ofs_y = 0},
    {.bitmap_index = 559, .adv_w = 98, .box_w = 5, .box_h = 7, .ofs_x = 1, .ofs_y = 0},
    {.bitmap_index = 564, .adv_w = 75, .box_w = 4, .box_h = 9, .ofs_x = 0, .ofs_y = 0},
    {.bitmap_index = 569, .adv_w = 116, .box_w = 6, .box_h = 7, .ofs_x = 1, .ofs_y = 0},
    {.bitmap_index = 575, .adv_w = 106, .box_w = 7, .box_h = 7, .ofs_x = 0, .ofs_y = 0},
    {.bitmap_index = 582, .adv_w = 161, .box_w = 10, .box_h = 7, .ofs_x = 0, .ofs_y = 0},
    {.bitmap_index = 591, .adv_w = 101, .box_w = 6, .box_h = 7, .ofs_x = 0, .ofs_y = 0},
    {.bitmap_index = 597, .adv_w = 106, .box_w = 7, .box_h = 10, .ofs_x = 0, .ofs_y = -3},
    {.bitmap_index = 606, .adv_w = 99, .box_w = 5, .box_h = 7, .ofs_x = 1, .ofs_y = 0},
    {.bitmap_index = 611, .adv_w = 81, .box_w = 3, .box_h = 12, .ofs_x = 1, .ofs_y = -2},
    {.bitmap_index = 616, .adv_w = 49, .box_w = 1, .box_h = 14, .ofs_x = 1, .ofs_y = -3},
    {.bitmap_index = 618, .adv_w = 81, .box_w = 3, .box_h = 12, .ofs_x = 1, .ofs_y = -2},
    {.bitmap_index = 623, .adv_w = 116, .box_w = 6, .box_h = 2, .ofs_x = 1, .ofs_y = 3}
};

/*---------------------
 *  CHARACTER MAPPING
 *--------------------*/



/*Collect the unicode lists and glyph_id offsets*/
static const lv_font_fmt_txt_cmap_t cmaps[] =
{
    {
        .range_start = 32, .range_length = 95, .glyph_id_start = 1,
        .unicode_list = NULL, .glyph_id_ofs_list = NULL, .list_length = 0, .type = LV_FONT_FMT_TXT_CMAP_FORMAT0_TINY
    }
};

/*-----------------
 *    KERNING
 *----------------*/


/*Pair left and right glyphs for kerning*/
static const uint8_t kern_pair_glyph_ids[] =
{
    2, 10,
    2, 18,
    3, 2,
    3, 4,
    3, 7,
    3, 9,
    3, 10,
    3, 15,
    3, 16,
    3, 21,
    3, 23,
    3, 25,
    3, 33,
    3, 64,
    3, 92,
    4, 9,
    4, 10,
    4, 15,
    4, 16,
    4, 18,
    4, 24,
    4, 62,
    5, 18,
    5, 19,
    5, 20,
    6, 19,
    6, 20,
    6, 21,
    6, 23,
    6, 24,
    7, 3,
    7, 8,
    7, 10,
    7, 18,
    7, 21,
    7, 22,
    7, 23,
    7, 24,
    7, 62,
    8, 2,
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
};

/* Kerning between the respective left and right glyphs
 * 4.4 format which needs to scaled with `kern_scale`*/
static const int8_t kern_pair_values[] =
{
    0, 0, 0, -7, -7, 0, 0, -9,
    -17, -9, -4, 0, -5, -25, 0, -2,
    -2, -5, -6, 5, 3, -7, 0, 0,
    0, 4, 5, 5, 2, 0, -3, -3,
    -8, -2, 4, 3, 0, 0, -3, 0,
    -7, -7, 0, 0, -9, -17, -9, -4,
    0, -5, -25, 0, -2, 0, -3, -10,
    0, 0, -3, -5, 0, 0, -2, -2,
    2, -3, 5, 0, 0, -3, 0, 0,
    0, -4, -3, 3, -26, -11, 8, 3,
    -4, 0, 8, 0, -7, -4, -5, -10,
    0, -10, -3, -7, -2, -5, -26, 0,
    -9, 0, 0, 0, -11, -6, 0, -2,
    11, 3, -3, -2, 2, 0, -3, -10,
    0, -10, -3, -7, -2, -5, -26, 0,
    -9, 0, 0, 0, -11, -6, 0, -2,
    -9, -5, -18, -9, -3, 0, 0, 0,
    -12, -12, 5, 0, 0, -7, -7, -23,
    0, -4, 3, -5, -3, 0, 0, 0,
    -2, -3, -4, 2, 0, 0, 0, 0,
    -2, 0, 0, 0, 0, 0, 0, 0,
    0, 0, 0, -4, 2, -3, 0, 0,
    0, 0, -2, 0, 0, 0, -3, 0,
    -2, 4, -3, 2, -2, 0, 0, -4,
    0, 5, 0, 3, 0, -3, 2, -5,
    0, 0, -5, 0, 3, 0, -2, -2,
    0, 0, -3, 0, -2, -3, 3, -4,
    -3, 0, -3, -2, 0, 0, -4, 0,
    0, -4, -2, -6, -9, 0, 2, -4,
    0, 2, -5, 0, 7, -6, -24, -6,
    -23, -14, 0, 0, 0, -2, -15, -4,
    -15, 0, -2, -2, -2, -9, 2, -4,
    4, 2, -17, 3, 0, 0, 0, 0,
    0, 0, 2, 0, 0, 0, 0, 4,
    0, 0, -17, -18, -12, 4, 0, 0,
    -4, 0, 0, 0, 0, 0, -15, -2,
    0, 0, -2, -2, 0, 0, -2, 0,
    -8, 0, -2, -4, 0, 0, 2, -14,
    -10, 6, -1, 0, 2, 0, 0, 0,
    -3, -3, -2, 4, 0, 0, -7, -15,
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
};

/*Collect the kern pair's data in one place*/
static const lv_font_fmt_txt_kern_pair_t kern_pairs =
{
    .glyph_ids = kern_pair_glyph_ids,
    .values = kern_pair_values,
    .pair_cnt = 374,
    .glyph_ids_size = 0
};

/*--------------------
 *  ALL CUSTOM DATA
 *--------------------*/

#if LVGL_VERSION_MAJOR == 8
/*Store all the custom data of the font*/
static  lv_font_fmt_txt_glyph_cache_t cache;
#endif

#if LVGL_VERSION_MAJOR >= 8
static const lv_font_fmt_txt_dsc_t font_dsc = {
#else
static lv_font_fmt_txt_dsc_t font_dsc = {
#endif
    .glyph_bitmap = glyph_bitmap,
    .glyph_dsc = glyph_dsc,
    .cmaps = cmaps,
    .kern_dsc = &kern_pairs,
    .kern_scale = 16,
    .cmap_num = 1,
    .bpp = 1,
    .kern_classes = 0,
    .bitmap_format = 0,
#if LVGL_VERSION_MAJOR == 8
    .cache = &cache
#endif
};



/*-----------------
 *  PUBLIC FONT
 *----------------*/

/*Initialize a public general font descriptor*/
#if LVGL_VERSION_MAJOR >= 8
const lv_font_t lvgl_font_google_sans_flex_regular_13 = {
#else
lv_font_t lvgl_font_google_sans_flex_regular_13 = {
#endif
    .get_glyph_dsc = lv_font_get_glyph_dsc_fmt_txt,    /*Function pointer to get glyph's data*/
    .get_glyph_bitmap = lv_font_get_bitmap_fmt_txt,    /*Function pointer to get glyph's bitmap*/
    .line_height = 14,          /*The maximum line height required by the font*/
    .base_line = 3,             /*Baseline measured from the bottom of the line*/
#if !(LVGL_VERSION_MAJOR == 6 && LVGL_VERSION_MINOR == 0)
    .subpx = LV_FONT_SUBPX_NONE,
#endif
#if LV_VERSION_CHECK(7, 4, 0) || LVGL_VERSION_MAJOR >= 8
    .underline_position = -2,
    .underline_thickness = 1,
#endif
    .dsc = &font_dsc,          /*The custom font data. Will be accessed by `get_glyph_bitmap/dsc` */
#if LV_VERSION_CHECK(8, 2, 0) || LVGL_VERSION_MAJOR >= 9
    .fallback = NULL,
#endif
    .user_data = NULL,
};



#endif /*#if LVGL_FONT_GOOGLE_SANS_FLEX_REGULAR_13*/
