Xinyuan-LilyGO/T-Echo-Lite/examples/T-Echo-Lite-KeyShield/general_test/lvgl_font_google_sans_flex_regular_14.c

/*******************************************************************************
 * Size: 14 px
 * Bpp: 1
 * Opts: --font assets\font\google_sans_flex\GoogleSansFlex_24pt-Regular.ttf -r 0x20-0x7E --size 14 --bpp 1 --format lvgl --lv-include lvgl.h --lv-font-name lvgl_font_google_sans_flex_regular_14 --no-compress -o examples\T-Echo-Lite-KeyShield\general_test\lvgl_font_google_sans_flex_regular_14.c
 ******************************************************************************/

#ifdef LV_LVGL_H_INCLUDE_SIMPLE
#include "lvgl.h"
#else
#include "lvgl.h"
#endif

#ifndef LVGL_FONT_GOOGLE_SANS_FLEX_REGULAR_14
#define LVGL_FONT_GOOGLE_SANS_FLEX_REGULAR_14 1
#endif

#if LVGL_FONT_GOOGLE_SANS_FLEX_REGULAR_14

/*-----------------
 *    BITMAPS
 *----------------*/

/*Store the image of the glyphs*/
static LV_ATTRIBUTE_LARGE_CONST const uint8_t glyph_bitmap[] = {
    /* U+0020 " " */
    0x0,

    /* U+0021 "!" */
    0xfe, 0x60,

    /* U+0022 "\"" */
    0xb6, 0xd0,

    /* U+0023 "#" */
    0x12, 0x9, 0x4, 0x8f, 0xe1, 0x21, 0xb0, 0x90,
    0xfe, 0x24, 0x12, 0x9, 0x0,

    /* U+0024 "$" */
    0x11, 0xe9, 0xe4, 0x93, 0xc3, 0x87, 0x16, 0x5d,
    0xde, 0x10, 0x40,

    /* U+0025 "%" */
    0x70, 0x91, 0x32, 0x24, 0x45, 0x7, 0x20, 0x8,
    0x2, 0x70, 0x51, 0x12, 0x26, 0x44, 0x87, 0x0,

    /* U+0026 "&" */
    0x38, 0x48, 0x40, 0x60, 0x60, 0xd0, 0x98, 0x8a,
    0x86, 0xc6, 0x7a,

    /* U+0027 "'" */
    0xf0,

    /* U+0028 "(" */
    0x2d, 0x29, 0x24, 0x91, 0x26, 0x40,

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

    /* U+007B "{" */
    0x34, 0x44, 0x44, 0x48, 0x44, 0x44, 0x43,

    /* U+007C "|" */
    0xff, 0xfe,

    /* U+007D "}" */
    0xc2, 0x22, 0x22, 0x21, 0x22, 0x22, 0x2c,

    /* U+007E "~" */
    0x65, 0x38
};


/*---------------------
 *  GLYPH DESCRIPTION
 *--------------------*/

static const lv_font_fmt_txt_glyph_dsc_t glyph_dsc[] = {
    {.bitmap_index = 0, .adv_w = 0, .box_w = 0, .box_h = 0, .ofs_x = 0, .ofs_y = 0} /* id = 0 reserved */,
    {.bitmap_index = 0, .adv_w = 50, .box_w = 1, .box_h = 1, .ofs_x = 0, .ofs_y = 0},
    {.bitmap_index = 1, .adv_w = 72, .box_w = 1, .box_h = 11, .ofs_x = 1, .ofs_y = 0},
    {.bitmap_index = 3, .adv_w = 72, .box_w = 3, .box_h = 4, .ofs_x = 1, .ofs_y = 7},
    {.bitmap_index = 5, .adv_w = 143, .box_w = 9, .box_h = 11, .ofs_x = 0, .ofs_y = 0},
    {.bitmap_index = 18, .adv_w = 135, .box_w = 6, .box_h = 14, .ofs_x = 1, .ofs_y = -2},
    {.bitmap_index = 29, .adv_w = 186, .box_w = 11, .box_h = 11, .ofs_x = 1, .ofs_y = 0},
    {.bitmap_index = 45, .adv_w = 140, .box_w = 8, .box_h = 11, .ofs_x = 1, .ofs_y = 0},
    {.bitmap_index = 56, .adv_w = 40, .box_w = 1, .box_h = 4, .ofs_x = 1, .ofs_y = 7},
    {.bitmap_index = 57, .adv_w = 73, .box_w = 3, .box_h = 14, .ofs_x = 1, .ofs_y = -2},
    {.bitmap_index = 63, .adv_w = 73, .box_w = 3, .box_h = 14, .ofs_x = 1, .ofs_y = -2},
    {.bitmap_index = 69, .adv_w = 95, .box_w = 5, .box_h = 5, .ofs_x = 0, .ofs_y = 6},
    {.bitmap_index = 73, .adv_w = 125, .box_w = 6, .box_h = 7, .ofs_x = 1, .ofs_y = 1},
    {.bitmap_index = 79, .adv_w = 53, .box_w = 2, .box_h = 3, .ofs_x = 1, .ofs_y = -1},
    {.bitmap_index = 80, .adv_w = 75, .box_w = 4, .box_h = 1, .ofs_x = 1, .ofs_y = 5},
    {.bitmap_index = 81, .adv_w = 53, .box_w = 2, .box_h = 2, .ofs_x = 1, .ofs_y = 0},
    {.bitmap_index = 82, .adv_w = 67, .box_w = 4, .box_h = 11, .ofs_x = 0, .ofs_y = 0},
    {.bitmap_index = 88, .adv_w = 144, .box_w = 8, .box_h = 11, .ofs_x = 1, .ofs_y = 0},
    {.bitmap_index = 99, .adv_w = 82, .box_w = 3, .box_h = 11, .ofs_x = 1, .ofs_y = 0},
    {.bitmap_index = 104, .adv_w = 118, .box_w = 6, .box_h = 11, .ofs_x = 1, .ofs_y = 0},
    {.bitmap_index = 113, .adv_w = 120, .box_w = 6, .box_h = 11, .ofs_x = 0, .ofs_y = 0},
    {.bitmap_index = 122, .adv_w = 132, .box_w = 7, .box_h = 11, .ofs_x = 0, .ofs_y = 0},
    {.bitmap_index = 132, .adv_w = 126, .box_w = 6, .box_h = 11, .ofs_x = 1, .ofs_y = 0},
    {.bitmap_index = 141, .adv_w = 125, .box_w = 7, .box_h = 11, .ofs_x = 1, .ofs_y = 0},
    {.bitmap_index = 151, .adv_w = 111, .box_w = 6, .box_h = 11, .ofs_x = 1, .ofs_y = 0},
    {.bitmap_index = 160, .adv_w = 124, .box_w = 6, .box_h = 11, .ofs_x = 1, .ofs_y = 0},
    {.bitmap_index = 169, .adv_w = 125, .box_w = 7, .box_h = 10, .ofs_x = 1, .ofs_y = 1},
    {.bitmap_index = 178, .adv_w = 53, .box_w = 2, .box_h = 8, .ofs_x = 1, .ofs_y = 0},
    {.bitmap_index = 180, .adv_w = 53, .box_w = 2, .box_h = 9, .ofs_x = 1, .ofs_y = -1},
    {.bitmap_index = 183, .adv_w = 125, .box_w = 6, .box_h = 7, .ofs_x = 1, .ofs_y = 1},
    {.bitmap_index = 189, .adv_w = 125, .box_w = 6, .box_h = 4, .ofs_x = 1, .ofs_y = 3},
    {.bitmap_index = 192, .adv_w = 125, .box_w = 6, .box_h = 7, .ofs_x = 1, .ofs_y = 1},
    {.bitmap_index = 198, .adv_w = 107, .box_w = 6, .box_h = 11, .ofs_x = 0, .ofs_y = 0},
    {.bitmap_index = 207, .adv_w = 198, .box_w = 11, .box_h = 12, .ofs_x = 1, .ofs_y = -1},
    {.bitmap_index = 224, .adv_w = 150, .box_w = 9, .box_h = 11, .ofs_x = 0, .ofs_y = 0},
    {.bitmap_index = 237, .adv_w = 135, .box_w = 7, .box_h = 11, .ofs_x = 1, .ofs_y = 0},
    {.bitmap_index = 247, .adv_w = 164, .box_w = 9, .box_h = 11, .ofs_x = 1, .ofs_y = 0},
    {.bitmap_index = 260, .adv_w = 157, .box_w = 8, .box_h = 11, .ofs_x = 1, .ofs_y = 0},
    {.bitmap_index = 271, .adv_w = 123, .box_w = 6, .box_h = 11, .ofs_x = 1, .ofs_y = 0},
    {.bitmap_index = 280, .adv_w = 118, .box_w = 6, .box_h = 11, .ofs_x = 1, .ofs_y = 0},
    {.bitmap_index = 289, .adv_w = 176, .box_w = 10, .box_h = 11, .ofs_x = 1, .ofs_y = 0},
    {.bitmap_index = 303, .adv_w = 156, .box_w = 7, .box_h = 11, .ofs_x = 1, .ofs_y = 0},
    {.bitmap_index = 313, .adv_w = 54, .box_w = 1, .box_h = 11, .ofs_x = 1, .ofs_y = 0},
    {.bitmap_index = 315, .adv_w = 118, .box_w = 6, .box_h = 11, .ofs_x = 0, .ofs_y = 0},
    {.bitmap_index = 324, .adv_w = 140, .box_w = 7, .box_h = 11, .ofs_x = 1, .ofs_y = 0},
    {.bitmap_index = 334, .adv_w = 113, .box_w = 5, .box_h = 11, .ofs_x = 1, .ofs_y = 0},
    {.bitmap_index = 341, .adv_w = 193, .box_w = 10, .box_h = 11, .ofs_x = 1, .ofs_y = 0},
    {.bitmap_index = 355, .adv_w = 158, .box_w = 8, .box_h = 11, .ofs_x = 1, .ofs_y = 0},
    {.bitmap_index = 366, .adv_w = 184, .box_w = 10, .box_h = 11, .ofs_x = 1, .ofs_y = 0},
    {.bitmap_index = 380, .adv_w = 129, .box_w = 6, .box_h = 11, .ofs_x = 1, .ofs_y = 0},
    {.bitmap_index = 389, .adv_w = 184, .box_w = 10, .box_h = 12, .ofs_x = 1, .ofs_y = -1},
    {.bitmap_index = 404, .adv_w = 131, .box_w = 6, .box_h = 11, .ofs_x = 1, .ofs_y = 0},
    {.bitmap_index = 413, .adv_w = 123, .box_w = 6, .box_h = 11, .ofs_x = 1, .ofs_y = 0},
    {.bitmap_index = 422, .adv_w = 120, .box_w = 7, .box_h = 11, .ofs_x = 0, .ofs_y = 0},
    {.bitmap_index = 432, .adv_w = 146, .box_w = 7, .box_h = 11, .ofs_x = 1, .ofs_y = 0},
    {.bitmap_index = 442, .adv_w = 141, .box_w = 9, .box_h = 11, .ofs_x = 0, .ofs_y = 0},
    {.bitmap_index = 455, .adv_w = 211, .box_w = 13, .box_h = 11, .ofs_x = 0, .ofs_y = 0},
    {.bitmap_index = 473, .adv_w = 142, .box_w = 9, .box_h = 11, .ofs_x = 0, .ofs_y = 0},
    {.bitmap_index = 486, .adv_w = 133, .box_w = 7, .box_h = 11, .ofs_x = 1, .ofs_y = 0},
    {.bitmap_index = 496, .adv_w = 128, .box_w = 7, .box_h = 11, .ofs_x = 1, .ofs_y = 0},
    {.bitmap_index = 506, .adv_w = 85, .box_w = 3, .box_h = 14, .ofs_x = 2, .ofs_y = -2},
    {.bitmap_index = 512, .adv_w = 67, .box_w = 4, .box_h = 11, .ofs_x = 0, .ofs_y = 0},
    {.bitmap_index = 518, .adv_w = 85, .box_w = 3, .box_h = 14, .ofs_x = 1, .ofs_y = -2},
    {.bitmap_index = 524, .adv_w = 104, .box_w = 6, .box_h = 5, .ofs_x = 0, .ofs_y = 6},
    {.bitmap_index = 528, .adv_w = 125, .box_w = 7, .box_h = 1, .ofs_x = 1, .ofs_y = -2},
    {.bitmap_index = 529, .adv_w = 100, .box_w = 2, .box_h = 2, .ofs_x = 2, .ofs_y = 9},
    {.bitmap_index = 530, .adv_w = 119, .box_w = 6, .box_h = 8, .ofs_x = 1, .ofs_y = 0},
    {.bitmap_index = 536, .adv_w = 134, .box_w = 7, .box_h = 11, .ofs_x = 1, .ofs_y = 0},
    {.bitmap_index = 546, .adv_w = 121, .box_w = 7, .box_h = 8, .ofs_x = 1, .ofs_y = 0},
    {.bitmap_index = 553, .adv_w = 134, .box_w = 7, .box_h = 11, .ofs_x = 1, .ofs_y = 0},
    {.bitmap_index = 563, .adv_w = 126, .box_w = 7, .box_h = 8, .ofs_x = 1, .ofs_y = 0},
    {.bitmap_index = 570, .adv_w = 84, .box_w = 5, .box_h = 11, .ofs_x = 1, .ofs_y = 0},
    {.bitmap_index = 577, .adv_w = 133, .box_w = 7, .box_h = 11, .ofs_x = 1, .ofs_y = -3},
    {.bitmap_index = 587, .adv_w = 125, .box_w = 6, .box_h = 11, .ofs_x = 1, .ofs_y = 0},
    {.bitmap_index = 596, .adv_w = 50, .box_w = 1, .box_h = 11, .ofs_x = 1, .ofs_y = 0},
    {.bitmap_index = 598, .adv_w = 50, .box_w = 3, .box_h = 14, .ofs_x = -1, .ofs_y = -3},
    {.bitmap_index = 604, .adv_w = 113, .box_w = 6, .box_h = 11, .ofs_x = 1, .ofs_y = 0},
    {.bitmap_index = 613, .adv_w = 47, .box_w = 1, .box_h = 11, .ofs_x = 1, .ofs_y = 0},
    {.bitmap_index = 615, .adv_w = 196, .box_w = 11, .box_h = 8, .ofs_x = 1, .ofs_y = 0},
    {.bitmap_index = 626, .adv_w = 125, .box_w = 6, .box_h = 8, .ofs_x = 1, .ofs_y = 0},
    {.bitmap_index = 632, .adv_w = 133, .box_w = 7, .box_h = 8, .ofs_x = 1, .ofs_y = 0},
    {.bitmap_index = 639, .adv_w = 134, .box_w = 7, .box_h = 11, .ofs_x = 1, .ofs_y = -3},
    {.bitmap_index = 649, .adv_w = 134, .box_w = 7, .box_h = 11, .ofs_x = 1, .ofs_y = -3},
    {.bitmap_index = 659, .adv_w = 83, .box_w = 4, .box_h = 8, .ofs_x = 1, .ofs_y = 0},
    {.bitmap_index = 663, .adv_w = 105, .box_w = 5, .box_h = 8, .ofs_x = 1, .ofs_y = 0},
    {.bitmap_index = 668, .adv_w = 81, .box_w = 4, .box_h = 10, .ofs_x = 1, .ofs_y = 0},
    {.bitmap_index = 673, .adv_w = 125, .box_w = 6, .box_h = 8, .ofs_x = 1, .ofs_y = 0},
    {.bitmap_index = 679, .adv_w = 115, .box_w = 7, .box_h = 8, .ofs_x = 0, .ofs_y = 0},
    {.bitmap_index = 686, .adv_w = 174, .box_w = 11, .box_h = 8, .ofs_x = 0, .ofs_y = 0},
    {.bitmap_index = 697, .adv_w = 109, .box_w = 7, .box_h = 8, .ofs_x = 0, .ofs_y = 0},
    {.bitmap_index = 704, .adv_w = 114, .box_w = 7, .box_h = 11, .ofs_x = 0, .ofs_y = -3},
    {.bitmap_index = 714, .adv_w = 107, .box_w = 6, .box_h = 8, .ofs_x = 1, .ofs_y = 0},
    {.bitmap_index = 720, .adv_w = 88, .box_w = 4, .box_h = 14, .ofs_x = 1, .ofs_y = -2},
    {.bitmap_index = 727, .adv_w = 53, .box_w = 1, .box_h = 15, .ofs_x = 1, .ofs_y = -3},
    {.bitmap_index = 729, .adv_w = 88, .box_w = 4, .box_h = 14, .ofs_x = 0, .ofs_y = -2},
    {.bitmap_index = 736, .adv_w = 125, .box_w = 7, .box_h = 2, .ofs_x = 1, .ofs_y = 4}
};

/*---------------------
 *  CHARACTER MAPPING
 *--------------------*/



/*Collect the unicode lists and glyph_id offsets*/
static const lv_font_fmt_txt_cmap_t cmaps[] =
{
    {
        .range_start = 32, .range_length = 95, .glyph_id_start = 1,
        .unicode_list = NULL, .glyph_id_ofs_list = NULL, .list_length = 0, .type = LV_FONT_FMT_TXT_CMAP_FORMAT0_TINY
    }
};

/*-----------------
 *    KERNING
 *----------------*/


/*Pair left and right glyphs for kerning*/
static const uint8_t kern_pair_glyph_ids[] =
{
    2, 10,
    2, 18,
    3, 2,
    3, 4,
    3, 7,
    3, 9,
    3, 10,
    3, 15,
    3, 16,
    3, 21,
    3, 23,
    3, 25,
    3, 33,
    3, 64,
    3, 92,
    4, 9,
    4, 10,
    4, 15,
    4, 16,
    4, 18,
    4, 24,
    4, 62,
    5, 18,
    5, 19,
    5, 20,
    6, 19,
    6, 20,
    6, 21,
    6, 23,
    6, 24,
    7, 3,
    7, 8,
    7, 10,
    7, 18,
    7, 21,
    7, 22,
    7, 23,
    7, 24,
    7, 62,
    8, 2,
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
};

/* Kerning between the respective left and right glyphs
 * 4.4 format which needs to scaled with `kern_scale`*/
static const int8_t kern_pair_values[] =
{
    0, 0, 0, -7, -8, 0, 0, -10,
    -18, -9, -4, 0, -5, -27, 0, -2,
    -2, -6, -7, 5, 3, -7, 0, 0,
    0, 5, 5, 5, 2, 0, -3, -3,
    -9, -2, 5, 3, 0, 0, -3, 0,
    -7, -8, 0, 0, -10, -18, -9, -4,
    0, -5, -27, 0, -2, 0, -3, -11,
    0, 0, -3, -6, 0, 0, -2, -2,
    2, -3, 6, 0, 0, -3, 0, 0,
    0, -4, -3, 3, -28, -11, 9, 3,
    -5, 0, 9, 0, -8, -4, -5, -10,
    0, -10, -3, -8, -3, -5, -28, 0,
    -10, 0, 0, 0, -12, -6, 0, -2,
    12, 3, -3, -3, 2, 0, -4, -10,
    0, -10, -3, -8, -3, -5, -28, 0,
    -10, 0, 0, 0, -12, -6, 0, -2,
    -10, -5, -19, -10, -3, 0, 0, 0,
    -13, -13, 5, 0, 0, -7, -7, -25,
    0, -5, 3, -5, -3, 0, 0, 0,
    -2, -3, -5, 2, 0, 0, 0, 0,
    -3, 0, 0, 0, 0, 0, 0, 0,
    0, 0, 0, -4, 2, -3, 0, 0,
    0, 0, -2, 0, 0, 0, -3, 0,
    -2, 4, -3, 2, -2, 0, 0, -4,
    0, 6, 0, 3, 0, -3, 2, -5,
    0, 0, -5, 0, 3, 0, -2, -2,
    0, 0, -3, 0, -2, -3, 3, -4,
    -3, 0, -3, -2, 0, 0, -4, 0,
    0, -4, -3, -6, -10, 0, 2, -4,
    0, 2, -6, 0, 8, -7, -26, -6,
    -25, -15, 0, 0, 0, -2, -17, -4,
    -17, 0, -2, -2, -2, -9, 2, -5,
    4, 3, -18, 3, 0, 0, 0, 0,
    0, 0, 2, 0, 0, 0, 0, 4,
    0, 0, -18, -19, -13, 4, 0, 0,
    -4, 0, 0, 0, 0, 0, -16, -2,
    0, 0, -2, -2, 0, 0, -2, 0,
    -8, 0, -2, -5, 0, 0, 2, -15,
    -11, 6, -1, 0, 2, 0, 0, 0,
    -3, -3, -2, 4, 0, 0, -8, -16,
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
};

/*Collect the kern pair's data in one place*/
static const lv_font_fmt_txt_kern_pair_t kern_pairs =
{
    .glyph_ids = kern_pair_glyph_ids,
    .values = kern_pair_values,
    .pair_cnt = 374,
    .glyph_ids_size = 0
};

/*--------------------
 *  ALL CUSTOM DATA
 *--------------------*/

#if LVGL_VERSION_MAJOR == 8
/*Store all the custom data of the font*/
static  lv_font_fmt_txt_glyph_cache_t cache;
#endif

#if LVGL_VERSION_MAJOR >= 8
static const lv_font_fmt_txt_dsc_t font_dsc = {
#else
static lv_font_fmt_txt_dsc_t font_dsc = {
#endif
    .glyph_bitmap = glyph_bitmap,
    .glyph_dsc = glyph_dsc,
    .cmaps = cmaps,
    .kern_dsc = &kern_pairs,
    .kern_scale = 16,
    .cmap_num = 1,
    .bpp = 1,
    .kern_classes = 0,
    .bitmap_format = 0,
#if LVGL_VERSION_MAJOR == 8
    .cache = &cache
#endif
};



/*-----------------
 *  PUBLIC FONT
 *----------------*/

/*Initialize a public general font descriptor*/
#if LVGL_VERSION_MAJOR >= 8
const lv_font_t lvgl_font_google_sans_flex_regular_14 = {
#else
lv_font_t lvgl_font_google_sans_flex_regular_14 = {
#endif
    .get_glyph_dsc = lv_font_get_glyph_dsc_fmt_txt,    /*Function pointer to get glyph's data*/
    .get_glyph_bitmap = lv_font_get_bitmap_fmt_txt,    /*Function pointer to get glyph's bitmap*/
    .line_height = 15,          /*The maximum line height required by the font*/
    .base_line = 3,             /*Baseline measured from the bottom of the line*/
#if !(LVGL_VERSION_MAJOR == 6 && LVGL_VERSION_MINOR == 0)
    .subpx = LV_FONT_SUBPX_NONE,
#endif
#if LV_VERSION_CHECK(7, 4, 0) || LVGL_VERSION_MAJOR >= 8
    .underline_position = -2,
    .underline_thickness = 1,
#endif
    .dsc = &font_dsc,          /*The custom font data. Will be accessed by `get_glyph_bitmap/dsc` */
#if LV_VERSION_CHECK(8, 2, 0) || LVGL_VERSION_MAJOR >= 9
    .fallback = NULL,
#endif
    .user_data = NULL,
};



#endif /*#if LVGL_FONT_GOOGLE_SANS_FLEX_REGULAR_14*/
