Xinyuan-LilyGO/T-Echo-Lite/examples/T-Echo-Lite-KeyShield/general_test/lvgl_font_google_sans_flex_regular_28.c

/*******************************************************************************
 * Size: 28 px
 * Bpp: 1
 * Opts: --font assets\font\google_sans_flex\GoogleSansFlex_36pt-Regular.ttf -r 0x20-0x7E --size 28 --bpp 1 --format lvgl --lv-include lvgl.h --lv-font-name lvgl_font_google_sans_flex_regular_28 --no-compress -o examples\T-Echo-Lite-KeyShield\general_test\lvgl_font_google_sans_flex_regular_28.c
 ******************************************************************************/

#ifdef LV_LVGL_H_INCLUDE_SIMPLE
#include "lvgl.h"
#else
#include "lvgl.h"
#endif

#ifndef LVGL_FONT_GOOGLE_SANS_FLEX_REGULAR_28
#define LVGL_FONT_GOOGLE_SANS_FLEX_REGULAR_28 1
#endif

#if LVGL_FONT_GOOGLE_SANS_FLEX_REGULAR_28

/*-----------------
 *    BITMAPS
 *----------------*/

/*Store the image of the glyphs*/
static LV_ATTRIBUTE_LARGE_CONST const uint8_t glyph_bitmap[] = {
    /* U+0020 " " */
    0x0,

    /* U+0021 "!" */
    0x6d, 0xb6, 0xdb, 0x6d, 0xb6, 0xc0, 0x1f, 0xf0,

    /* U+0022 "\"" */
    0xcf, 0x3c, 0xf3, 0xcf, 0x3c, 0xc0,

    /* U+0023 "#" */
    0x6, 0x18, 0x6, 0x18, 0x6, 0x18, 0x6, 0x18,
    0x6, 0x18, 0x7f, 0xff, 0x7f, 0xff, 0xc, 0x30,
    0xc, 0x30, 0xc, 0x30, 0xc, 0x30, 0xc, 0x30,
    0xff, 0xfe, 0xff, 0xfe, 0x18, 0x60, 0x18, 0x60,
    0x18, 0x60, 0x18, 0x60, 0x18, 0x60, 0x18, 0x60,

    /* U+0024 "$" */
    0x3, 0x0, 0xc, 0x0, 0x30, 0x3, 0xf0, 0x1f,
    0xf0, 0xec, 0xe6, 0x31, 0xd8, 0xc0, 0x63, 0x1,
    0xcc, 0x3, 0xb0, 0xf, 0xc0, 0xf, 0xc0, 0xf,
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
    0x18, 0x18, 0x18, 0x1c, 0xf, 0xf, 0x1c, 0x18,
    0x18, 0x18, 0x18, 0x18, 0x18, 0x18, 0x18, 0x38,
    0xf0, 0xe0,

    /* U+007E "~" */
    0x3c, 0x1b, 0xf9, 0xf9, 0xfd, 0x83, 0xc0
};


/*---------------------
 *  GLYPH DESCRIPTION
 *--------------------*/

static const lv_font_fmt_txt_glyph_dsc_t glyph_dsc[] = {
    {.bitmap_index = 0, .adv_w = 0, .box_w = 0, .box_h = 0, .ofs_x = 0, .ofs_y = 0} /* id = 0 reserved */,
    {.bitmap_index = 0, .adv_w = 99, .box_w = 1, .box_h = 1, .ofs_x = 0, .ofs_y = 0},
    {.bitmap_index = 1, .adv_w = 141, .box_w = 3, .box_h = 20, .ofs_x = 3, .ofs_y = 0},
    {.bitmap_index = 9, .adv_w = 144, .box_w = 6, .box_h = 7, .ofs_x = 1, .ofs_y = 13},
    {.bitmap_index = 15, .adv_w = 286, .box_w = 16, .box_h = 20, .ofs_x = 1, .ofs_y = 0},
    {.bitmap_index = 55, .adv_w = 269, .box_w = 14, .box_h = 26, .ofs_x = 1, .ofs_y = -3},
    {.bitmap_index = 101, .adv_w = 372, .box_w = 22, .box_h = 20, .ofs_x = 1, .ofs_y = 0},
    {.bitmap_index = 156, .adv_w = 280, .box_w = 15, .box_h = 20, .ofs_x = 1, .ofs_y = 0},
    {.bitmap_index = 194, .adv_w = 80, .box_w = 2, .box_h = 7, .ofs_x = 1, .ofs_y = 13},
    {.bitmap_index = 196, .adv_w = 146, .box_w = 7, .box_h = 27, .ofs_x = 2, .ofs_y = -4},
    {.bitmap_index = 220, .adv_w = 146, .box_w = 7, .box_h = 27, .ofs_x = 0, .ofs_y = -4},
    {.bitmap_index = 244, .adv_w = 190, .box_w = 10, .box_h = 10, .ofs_x = 1, .ofs_y = 11},
    {.bitmap_index = 257, .adv_w = 249, .box_w = 12, .box_h = 13, .ofs_x = 2, .ofs_y = 3},
    {.bitmap_index = 277, .adv_w = 106, .box_w = 4, .box_h = 6, .ofs_x = 2, .ofs_y = -3},
    {.bitmap_index = 280, .adv_w = 148, .box_w = 8, .box_h = 2, .ofs_x = 1, .ofs_y = 8},
    {.bitmap_index = 282, .adv_w = 106, .box_w = 4, .box_h = 3, .ofs_x = 2, .ofs_y = 0},
    {.bitmap_index = 284, .adv_w = 135, .box_w = 8, .box_h = 20, .ofs_x = 0, .ofs_y = 0},
    {.bitmap_index = 304, .adv_w = 285, .box_w = 15, .box_h = 20, .ofs_x = 1, .ofs_y = 0},
    {.bitmap_index = 342, .adv_w = 165, .box_w = 7, .box_h = 20, .ofs_x = 1, .ofs_y = 0},
    {.bitmap_index = 360, .adv_w = 235, .box_w = 12, .box_h = 20, .ofs_x = 1, .ofs_y = 0},
    {.bitmap_index = 390, .adv_w = 238, .box_w = 12, .box_h = 20, .ofs_x = 2, .ofs_y = 0},
    {.bitmap_index = 420, .adv_w = 262, .box_w = 15, .box_h = 20, .ofs_x = 1, .ofs_y = 0},
    {.bitmap_index = 458, .adv_w = 251, .box_w = 13, .box_h = 20, .ofs_x = 1, .ofs_y = 0},
    {.bitmap_index = 491, .adv_w = 248, .box_w = 13, .box_h = 21, .ofs_x = 1, .ofs_y = 0},
    {.bitmap_index = 526, .adv_w = 220, .box_w = 12, .box_h = 21, .ofs_x = 1, .ofs_y = -1},
    {.bitmap_index = 558, .adv_w = 248, .box_w = 13, .box_h = 20, .ofs_x = 1, .ofs_y = 0},
    {.bitmap_index = 591, .adv_w = 248, .box_w = 13, .box_h = 21, .ofs_x = 1, .ofs_y = -1},
    {.bitmap_index = 626, .adv_w = 106, .box_w = 4, .box_h = 15, .ofs_x = 2, .ofs_y = 0},
    {.bitmap_index = 634, .adv_w = 106, .box_w = 4, .box_h = 17, .ofs_x = 2, .ofs_y = -2},
    {.bitmap_index = 643, .adv_w = 249, .box_w = 12, .box_h = 12, .ofs_x = 2, .ofs_y = 3},
    {.bitmap_index = 661, .adv_w = 249, .box_w = 12, .box_h = 7, .ofs_x = 2, .ofs_y = 5},
    {.bitmap_index = 672, .adv_w = 249, .box_w = 12, .box_h = 12, .ofs_x = 2, .ofs_y = 3},
    {.bitmap_index = 690, .adv_w = 214, .box_w = 11, .box_h = 20, .ofs_x = 1, .ofs_y = 0},
    {.bitmap_index = 718, .adv_w = 394, .box_w = 22, .box_h = 22, .ofs_x = 1, .ofs_y = -2},
    {.bitmap_index = 779, .adv_w = 298, .box_w = 18, .box_h = 20, .ofs_x = 0, .ofs_y = 0},
    {.bitmap_index = 824, .adv_w = 268, .box_w = 13, .box_h = 20, .ofs_x = 2, .ofs_y = 0},
    {.bitmap_index = 857, .adv_w = 326, .box_w = 18, .box_h = 20, .ofs_x = 1, .ofs_y = 0},
    {.bitmap_index = 902, .adv_w = 312, .box_w = 16, .box_h = 20, .ofs_x = 2, .ofs_y = 0},
    {.bitmap_index = 942, .adv_w = 242, .box_w = 11, .box_h = 20, .ofs_x = 2, .ofs_y = 0},
    {.bitmap_index = 970, .adv_w = 233, .box_w = 11, .box_h = 20, .ofs_x = 2, .ofs_y = 0},
    {.bitmap_index = 998, .adv_w = 351, .box_w = 20, .box_h = 20, .ofs_x = 1, .ofs_y = 0},
    {.bitmap_index = 1048, .adv_w = 310, .box_w = 15, .box_h = 20, .ofs_x = 2, .ofs_y = 0},
    {.bitmap_index = 1086, .adv_w = 106, .box_w = 2, .box_h = 20, .ofs_x = 2, .ofs_y = 0},
    {.bitmap_index = 1091, .adv_w = 234, .box_w = 12, .box_h = 20, .ofs_x = 0, .ofs_y = 0},
    {.bitmap_index = 1121, .adv_w = 277, .box_w = 15, .box_h = 20, .ofs_x = 2, .ofs_y = 0},
    {.bitmap_index = 1159, .adv_w = 224, .box_w = 11, .box_h = 20, .ofs_x = 2, .ofs_y = 0},
    {.bitmap_index = 1187, .adv_w = 384, .box_w = 20, .box_h = 20, .ofs_x = 2, .ofs_y = 0},
    {.bitmap_index = 1237, .adv_w = 313, .box_w = 15, .box_h = 20, .ofs_x = 2, .ofs_y = 0},
    {.bitmap_index = 1275, .adv_w = 366, .box_w = 20, .box_h = 20, .ofs_x = 1, .ofs_y = 0},
    {.bitmap_index = 1325, .adv_w = 255, .box_w = 13, .box_h = 20, .ofs_x = 2, .ofs_y = 0},
    {.bitmap_index = 1358, .adv_w = 366, .box_w = 20, .box_h = 21, .ofs_x = 1, .ofs_y = -1},
    {.bitmap_index = 1411, .adv_w = 260, .box_w = 14, .box_h = 20, .ofs_x = 2, .ofs_y = 0},
    {.bitmap_index = 1446, .adv_w = 244, .box_w = 14, .box_h = 20, .ofs_x = 1, .ofs_y = 0},
    {.bitmap_index = 1481, .adv_w = 237, .box_w = 14, .box_h = 20, .ofs_x = 0, .ofs_y = 0},
    {.bitmap_index = 1516, .adv_w = 291, .box_w = 15, .box_h = 20, .ofs_x = 2, .ofs_y = 0},
    {.bitmap_index = 1554, .adv_w = 280, .box_w = 17, .box_h = 20, .ofs_x = 0, .ofs_y = 0},
    {.bitmap_index = 1597, .adv_w = 422, .box_w = 26, .box_h = 20, .ofs_x = 0, .ofs_y = 0},
    {.bitmap_index = 1662, .adv_w = 282, .box_w = 17, .box_h = 20, .ofs_x = 0, .ofs_y = 0},
    {.bitmap_index = 1705, .adv_w = 266, .box_w = 16, .box_h = 20, .ofs_x = 0, .ofs_y = 0},
    {.bitmap_index = 1745, .adv_w = 254, .box_w = 13, .box_h = 20, .ofs_x = 1, .ofs_y = 0},
    {.bitmap_index = 1778, .adv_w = 167, .box_w = 6, .box_h = 26, .ofs_x = 3, .ofs_y = -4},
    {.bitmap_index = 1798, .adv_w = 135, .box_w = 8, .box_h = 20, .ofs_x = 0, .ofs_y = 0},
    {.bitmap_index = 1818, .adv_w = 167, .box_w = 6, .box_h = 26, .ofs_x = 1, .ofs_y = -4},
    {.bitmap_index = 1838, .adv_w = 207, .box_w = 13, .box_h = 9, .ofs_x = 0, .ofs_y = 12},
    {.bitmap_index = 1853, .adv_w = 246, .box_w = 14, .box_h = 2, .ofs_x = 1, .ofs_y = -4},
    {.bitmap_index = 1857, .adv_w = 197, .box_w = 4, .box_h = 4, .ofs_x = 4, .ofs_y = 17},
    {.bitmap_index = 1859, .adv_w = 237, .box_w = 12, .box_h = 15, .ofs_x = 1, .ofs_y = 0},
    {.bitmap_index = 1882, .adv_w = 267, .box_w = 14, .box_h = 20, .ofs_x = 2, .ofs_y = 0},
    {.bitmap_index = 1917, .adv_w = 241, .box_w = 13, .box_h = 15, .ofs_x = 1, .ofs_y = 0},
    {.bitmap_index = 1942, .adv_w = 267, .box_w = 14, .box_h = 20, .ofs_x = 1, .ofs_y = 0},
    {.bitmap_index = 1977, .adv_w = 250, .box_w = 14, .box_h = 15, .ofs_x = 1, .ofs_y = 0},
    {.bitmap_index = 2004, .adv_w = 163, .box_w = 10, .box_h = 20, .ofs_x = 0, .ofs_y = 0},
    {.bitmap_index = 2029, .adv_w = 265, .box_w = 14, .box_h = 21, .ofs_x = 1, .ofs_y = -6},
    {.bitmap_index = 2066, .adv_w = 249, .box_w = 12, .box_h = 20, .ofs_x = 2, .ofs_y = 0},
    {.bitmap_index = 2096, .adv_w = 99, .box_w = 3, .box_h = 20, .ofs_x = 2, .ofs_y = 0},
    {.bitmap_index = 2104, .adv_w = 99, .box_w = 7, .box_h = 26, .ofs_x = -2, .ofs_y = -6},
    {.bitmap_index = 2127, .adv_w = 224, .box_w = 12, .box_h = 20, .ofs_x = 2, .ofs_y = 0},
    {.bitmap_index = 2157, .adv_w = 92, .box_w = 2, .box_h = 20, .ofs_x = 2, .ofs_y = 0},
    {.bitmap_index = 2162, .adv_w = 391, .box_w = 22, .box_h = 15, .ofs_x = 2, .ofs_y = 0},
    {.bitmap_index = 2204, .adv_w = 249, .box_w = 12, .box_h = 15, .ofs_x = 2, .ofs_y = 0},
    {.bitmap_index = 2227, .adv_w = 265, .box_w = 15, .box_h = 15, .ofs_x = 1, .ofs_y = 0},
    {.bitmap_index = 2256, .adv_w = 267, .box_w = 14, .box_h = 21, .ofs_x = 2, .ofs_y = -6},
    {.bitmap_index = 2293, .adv_w = 267, .box_w = 14, .box_h = 21, .ofs_x = 1, .ofs_y = -6},
    {.bitmap_index = 2330, .adv_w = 164, .box_w = 8, .box_h = 15, .ofs_x = 2, .ofs_y = 0},
    {.bitmap_index = 2345, .adv_w = 208, .box_w = 12, .box_h = 15, .ofs_x = 0, .ofs_y = 0},
    {.bitmap_index = 2368, .adv_w = 159, .box_w = 9, .box_h = 19, .ofs_x = 0, .ofs_y = 0},
    {.bitmap_index = 2390, .adv_w = 248, .box_w = 12, .box_h = 15, .ofs_x = 2, .ofs_y = 0},
    {.bitmap_index = 2413, .adv_w = 227, .box_w = 14, .box_h = 15, .ofs_x = 0, .ofs_y = 0},
    {.bitmap_index = 2440, .adv_w = 346, .box_w = 21, .box_h = 15, .ofs_x = 0, .ofs_y = 0},
    {.bitmap_index = 2480, .adv_w = 215, .box_w = 13, .box_h = 15, .ofs_x = 0, .ofs_y = 0},
    {.bitmap_index = 2505, .adv_w = 226, .box_w = 14, .box_h = 21, .ofs_x = 0, .ofs_y = -6},
    {.bitmap_index = 2542, .adv_w = 211, .box_w = 11, .box_h = 15, .ofs_x = 1, .ofs_y = 0},
    {.bitmap_index = 2563, .adv_w = 173, .box_w = 7, .box_h = 26, .ofs_x = 2, .ofs_y = -4},
    {.bitmap_index = 2586, .adv_w = 107, .box_w = 2, .box_h = 29, .ofs_x = 2, .ofs_y = -6},
    {.bitmap_index = 2594, .adv_w = 173, .box_w = 8, .box_h = 26, .ofs_x = 2, .ofs_y = -4},
    {.bitmap_index = 2620, .adv_w = 249, .box_w = 13, .box_h = 4, .ofs_x = 1, .ofs_y = 7}
};

/*---------------------
 *  CHARACTER MAPPING
 *--------------------*/



/*Collect the unicode lists and glyph_id offsets*/
static const lv_font_fmt_txt_cmap_t cmaps[] =
{
    {
        .range_start = 32, .range_length = 95, .glyph_id_start = 1,
        .unicode_list = NULL, .glyph_id_ofs_list = NULL, .list_length = 0, .type = LV_FONT_FMT_TXT_CMAP_FORMAT0_TINY
    }
};

/*-----------------
 *    KERNING
 *----------------*/


/*Pair left and right glyphs for kerning*/
static const uint8_t kern_pair_glyph_ids[] =
{
    2, 10,
    2, 18,
    3, 2,
    3, 4,
    3, 7,
    3, 9,
    3, 10,
    3, 15,
    3, 16,
    3, 21,
    3, 23,
    3, 25,
    3, 33,
    3, 64,
    3, 92,
    4, 9,
    4, 10,
    4, 15,
    4, 16,
    4, 18,
    4, 24,
    4, 62,
    5, 18,
    5, 19,
    5, 20,
    6, 19,
    6, 20,
    6, 21,
    6, 23,
    6, 24,
    7, 3,
    7, 8,
    7, 10,
    7, 18,
    7, 21,
    7, 22,
    7, 23,
    7, 24,
    7, 62,
    8, 2,
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
};

/* Kerning between the respective left and right glyphs
 * 4.4 format which needs to scaled with `kern_scale`*/
static const int8_t kern_pair_values[] =
{
    -1, 1, -1, -15, -15, -1, -1, -20,
    -36, -19, -8, -1, -10, -56, -1, -4,
    -4, -11, -13, 10, 6, -15, -1, -2,
    -1, 8, 11, 10, 4, -2, -6, -6,
    -18, -4, 9, 7, 1, -2, -7, -1,
    -15, -15, -1, -1, -20, -36, -19, -8,
    -1, -10, -56, -1, -5, -1, -7, -22,
    -1, -1, -6, -11, -1, -1, -4, -4,
    4, -7, 11, -1, -1, -7, -1, 1,
    -1, -9, -7, 7, -53, -23, 17, 7,
    -10, -1, 18, 1, -14, -7, -10, -23,
    -1, -23, -7, -16, -6, -11, -55, -1,
    -20, -2, -1, -2, -24, -13, -1, -4,
    24, 6, -6, -5, 3, 1, -6, -23,
    -1, -23, -7, -16, -6, -11, -55, -1,
    -20, -2, -1, -2, -24, -13, -1, -4,
    -20, -10, -38, -23, -7, -3, -1, -1,
    -26, -27, 9, -2, -1, -15, -15, -51,
    -1, -10, 6, -11, -7, 1, -1, -1,
    -5, -7, -9, 5, -1, 0, -1, -1,
    -6, -1, -1, -1, -1, -1, -2, 1,
    -2, -1, -1, -9, 4, -7, -1, -1,
    -1, -1, -4, -1, -1, -1, -6, 1,
    -6, 7, -7, 5, -6, -1, -2, -9,
    -1, 11, 1, 6, 1, -7, 5, -10,
    -2, 1, -12, 1, 6, -1, -4, -4,
    -2, -1, 0, 0, -6, -2, -5, -7,
    5, -8, -7, -1, -7, -5, -1, -1,
    -9, -1, 0, 1, -9, -6, -14, -21,
    -1, 6, -7, -1, 5, -13, 1, 16,
    -12, -53, -12, -50, -33, -2, 0, -1,
    -5, -34, -9, -33, 2, -5, -5, -5,
    -17, 5, -11, 7, 5, -39, 7, -1,
    -1, -1, -2, -2, -1, 5, -1, -2,
    -1, -2, 7, -1, 1, -37, -39, -28,
    8, -1, -1, -8, -1, -1, -1, -1,
    -1, -33, -5, -1, -1, -4, -5, -1,
    -1, -4, -1, -16, -1, -4, -9, -1,
    -1, 5, -31, -22, 12, -3, -1, 5,
    1, -1, -1, -6, -6, -4, 9, 1,
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
};

/*Collect the kern pair's data in one place*/
static const lv_font_fmt_txt_kern_pair_t kern_pairs =
{
    .glyph_ids = kern_pair_glyph_ids,
    .values = kern_pair_values,
    .pair_cnt = 377,
    .glyph_ids_size = 0
};

/*--------------------
 *  ALL CUSTOM DATA
 *--------------------*/

#if LVGL_VERSION_MAJOR == 8
/*Store all the custom data of the font*/
static  lv_font_fmt_txt_glyph_cache_t cache;
#endif

#if LVGL_VERSION_MAJOR >= 8
static const lv_font_fmt_txt_dsc_t font_dsc = {
#else
static lv_font_fmt_txt_dsc_t font_dsc = {
#endif
    .glyph_bitmap = glyph_bitmap,
    .glyph_dsc = glyph_dsc,
    .cmaps = cmaps,
    .kern_dsc = &kern_pairs,
    .kern_scale = 16,
    .cmap_num = 1,
    .bpp = 1,
    .kern_classes = 0,
    .bitmap_format = 0,
#if LVGL_VERSION_MAJOR == 8
    .cache = &cache
#endif
};



/*-----------------
 *  PUBLIC FONT
 *----------------*/

/*Initialize a public general font descriptor*/
#if LVGL_VERSION_MAJOR >= 8
const lv_font_t lvgl_font_google_sans_flex_regular_28 = {
#else
lv_font_t lvgl_font_google_sans_flex_regular_28 = {
#endif
    .get_glyph_dsc = lv_font_get_glyph_dsc_fmt_txt,    /*Function pointer to get glyph's data*/
    .get_glyph_bitmap = lv_font_get_bitmap_fmt_txt,    /*Function pointer to get glyph's bitmap*/
    .line_height = 29,          /*The maximum line height required by the font*/
    .base_line = 6,             /*Baseline measured from the bottom of the line*/
#if !(LVGL_VERSION_MAJOR == 6 && LVGL_VERSION_MINOR == 0)
    .subpx = LV_FONT_SUBPX_NONE,
#endif
#if LV_VERSION_CHECK(7, 4, 0) || LVGL_VERSION_MAJOR >= 8
    .underline_position = -4,
    .underline_thickness = 2,
#endif
    .dsc = &font_dsc,          /*The custom font data. Will be accessed by `get_glyph_bitmap/dsc` */
#if LV_VERSION_CHECK(8, 2, 0) || LVGL_VERSION_MAJOR >= 9
    .fallback = NULL,
#endif
    .user_data = NULL,
};



#endif /*#if LVGL_FONT_GOOGLE_SANS_FLEX_REGULAR_28*/
