Xinyuan-LilyGO/T-Echo-Lite/(commit log)

2024-12-10 Fix errors in PowerConsumptionTestLog
2025-01-23 Fix Lora and GPS errors
    [Display_SX1262.ino, GPS.ino, GPS_Full.ino, Original_Test.ino, SX126x_PingPong.ino, SX126x_PingPong_2.ino]
2025-02-12 Fix the issue where the Original_Test program gets stuck during the Lora test.
    [Original_Test.ino]
2025-03-13 Add RT9080_ EN switch
2025-03-17 Fix shallow sleep awakening issues
    [Original_Test.ino, Sleep_Wake_Up.ino]
2025-05-22 Update T_Echo_lite.PcbLib #1
    [T_Echo_lite.PcbLib]
2025-05-24 Update T_Echo_lite.SchLib #1
    [T_Echo_lite.SchLib]
2025-06-04 Update the description of the Bluetooth antenna and LoRa antenna.
2025-06-05 update T-Echo-Lite-Core_V1.0 #1
    [T-Echo-Lite-Core_V1.0.eprj, T-Echo-Lite-Core_V1.0.kicad_pcb, T-Echo-Lite-Core_V1.0.kicad_sch, T_Echo_lite.PcbLib, T_Echo_lite.SchLib]
2025-06-09 Update structure #1
    [上壳.stl, 下壳.stl, 总装.stl]
2025-10-30 add lora interruption clear flag
2025-11-14 add partial screen refresh functionality and fix screen refresh stuttering issues
    [Button_Triggered.ino, Display.ino, Display_BLE_Uart.ino, Display_SX1262.ino, Original_Test.ino, Sleep_Wake_Up.ino]
2026-04-14 update the iis of the CPP_BUS_DRIVER_DEVELOPMENT_FRAMEWORK_ARDUINO_NRF framework to adapt it to the latest cpp_bus_driver library
2026-06-05 Fix screen refresh issue.
    [lvgl_port.cpp]
2026-06-05 Add function comments to battery_view.
2026-06-10 Add volatile to prevent the screen refresh variable from being optimized away by the compiler.
    [general_test.ino]
2026-07-14 Add new model Flash as a replacement.
    [Flash.ino, Flash_Erase.ino, Flash_Speed_Test.ino, Original_Test.ino, Sleep_Wake_Up.ino, audio_view.cpp, nrf52840_module.cpp]
2026-07-31 Update the schematic. #14
2026-07-31 Fix S62F LoRa initialization and document issue #14
    [Display_SX1262.ino, Original_Test.ino, SX126x_PingPong.ino, SX126x_PingPong_2.ino, Sleep_Wake_Up.ino, nrf52840_module.cpp, sx1262_lora_view.cpp, sx126x_tx_continuous_wave.ino]
2026-10-14 fix(power): prevent power rail rebound during sleep
    - Hold RT9080_EN and GPS_RT9080_EN low with pulldown inputs
    - Prevent floating enable pins from reactivating peripheral power rails
2026-10-14 fix(general-test): stabilize sleep current and audio playback
    - Use pulldown inputs for power enable pins to prevent sleep current rebound
    - Fix I2S DMA buffer handoff during recording and playback
    - Add HEX and UF2 firmware for version 202610141155
    - Update firmware modification log
